FredericSegard/ZedEighty-Project/Part 7 - Keyboard Basic/Part 7 - Keyboard Basic (Rear).jpg

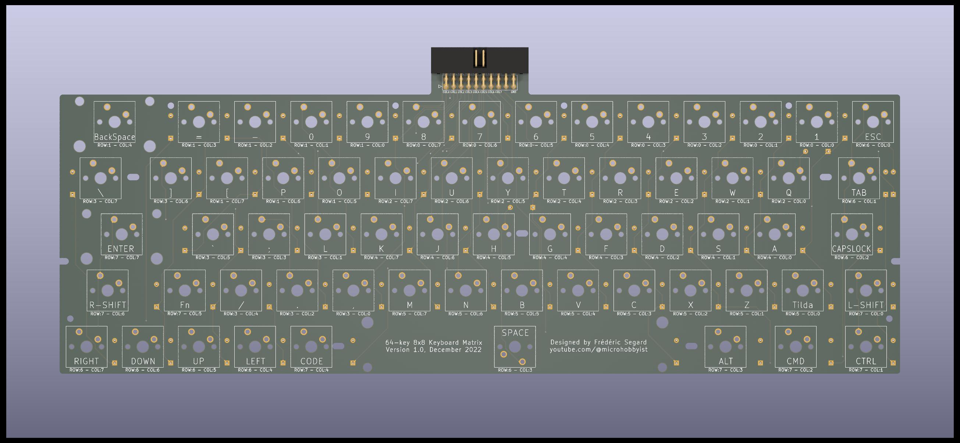
Part 7 - Keyboard Basic/Part 7 - Keyboard Basic (Rear).jpg
