FredericSegard/ZedEighty-Project/Part 7 - Keyboard Basic/Part 7 - Keyboard Basic (Angle).jpg

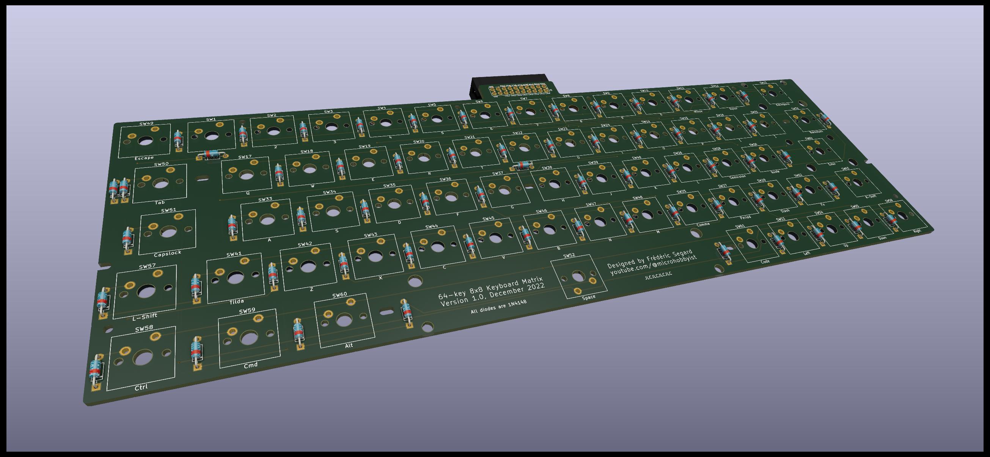
Part 7 - Keyboard Basic/Part 7 - Keyboard Basic (Angle).jpg
