FredericSegard/ZedEighty-Project/Part 3 - Mapping things out/ResetClockCardBack.jpg

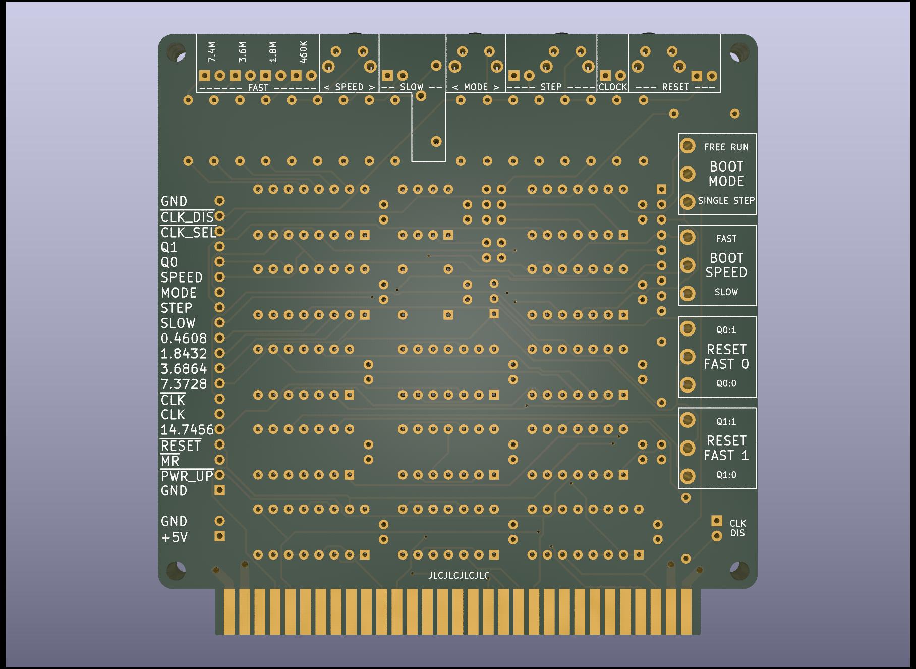
Part 3 - Mapping things out/ResetClockCardBack.jpg
