FredericSegard/ZedEighty-Project/Part 3 - Mapping things out/ResetClockCardFront.jpg

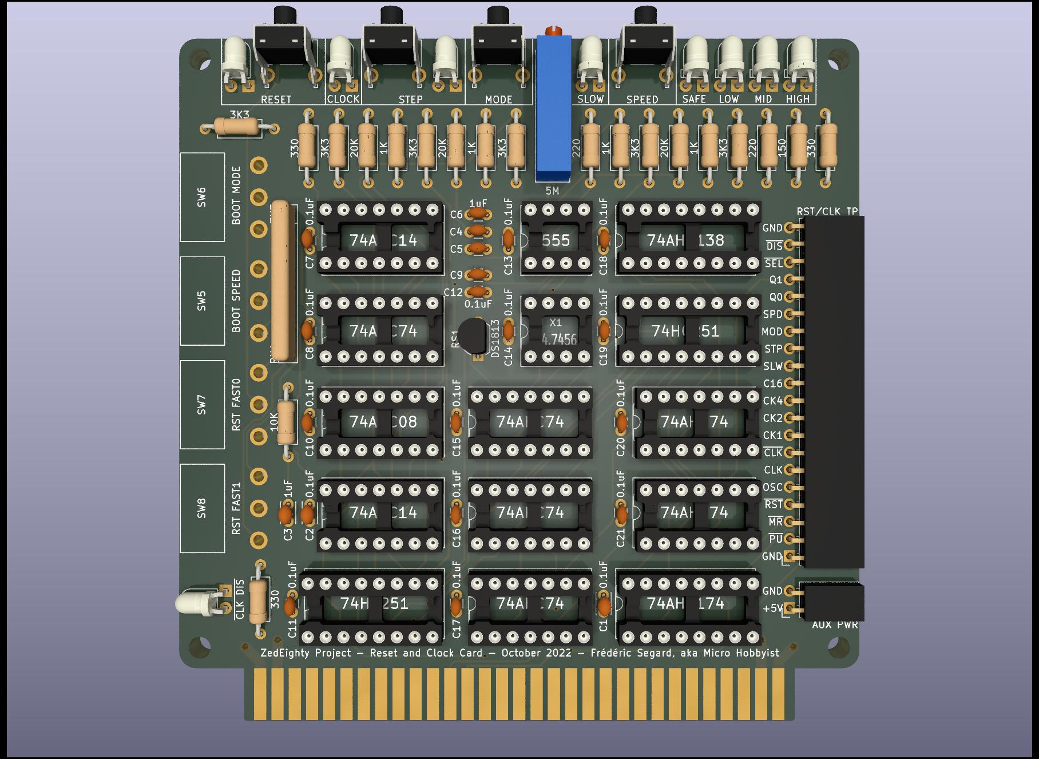
Part 3 - Mapping things out/ResetClockCardFront.jpg
