FredericSegard/ZedEighty-Project/Part 7 - Keyboard Basic/Part 7 - Keyboard Basic (Schematic).jpg

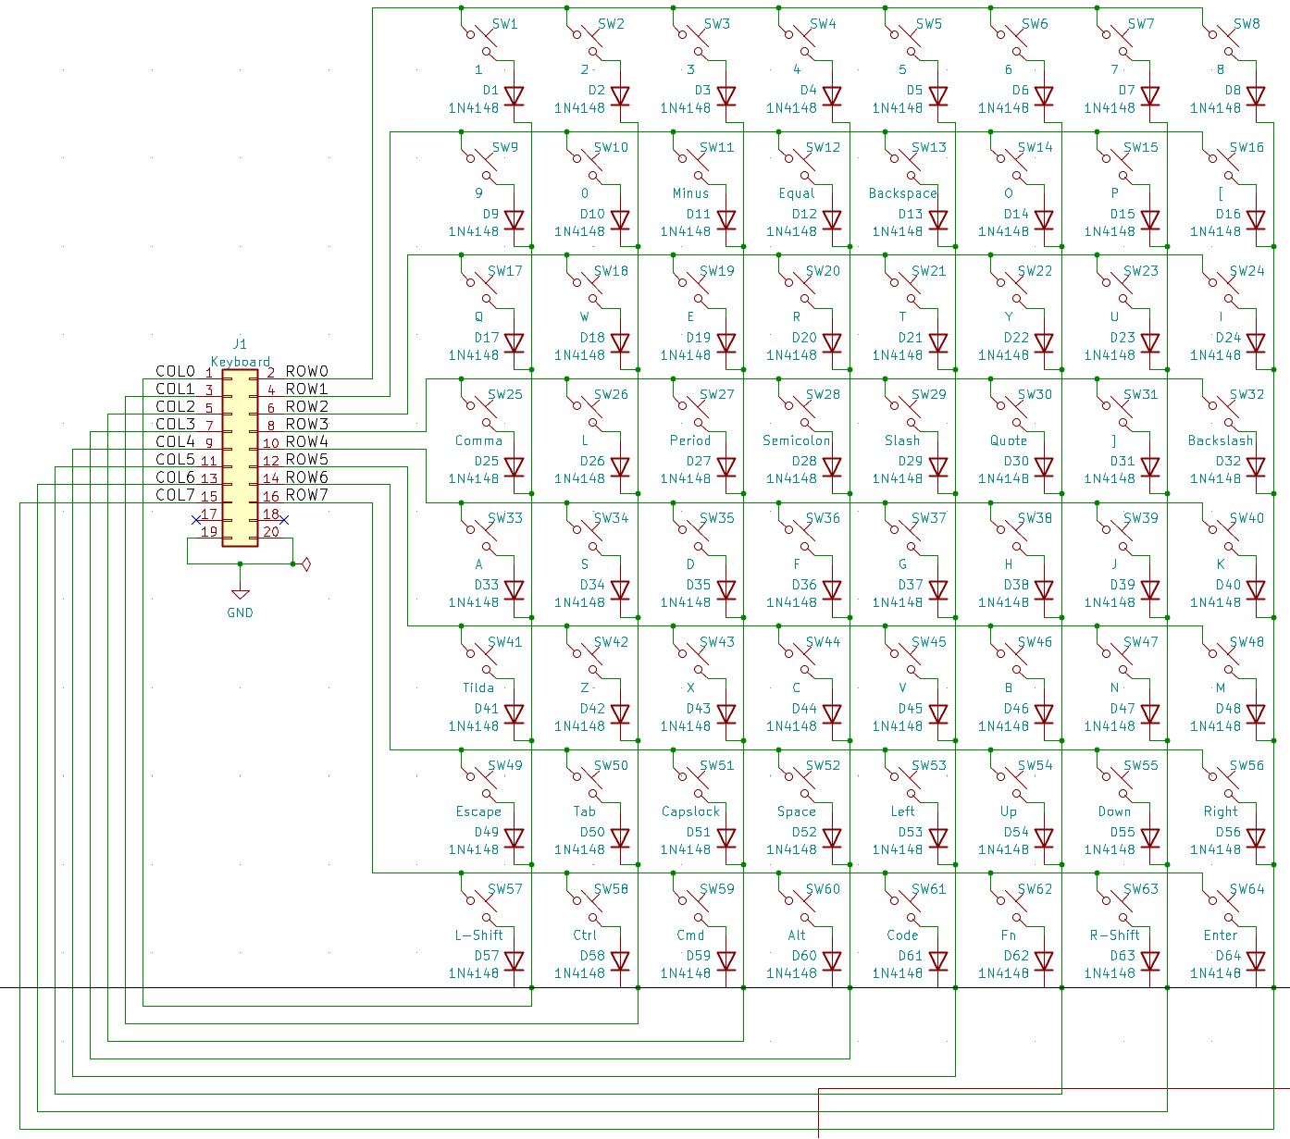
Part 7 - Keyboard Basic/Part 7 - Keyboard Basic (Schematic).jpg
