FredericSegard/ZedEighty-Project/0_Z80_Library/SW_Cherry_MX_PCB.step

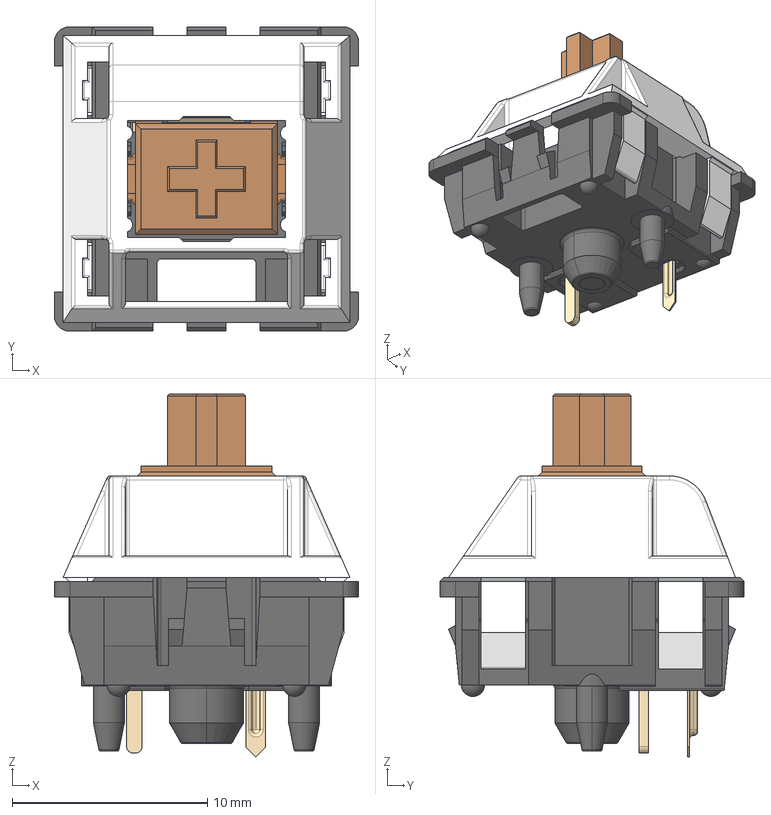
[picture p6: CAD file, 2022-11-07]
0_Z80_Library/SW_Cherry_MX_PCB.step
15.6 x 15.6 x 18.6 mm
