FredericSegard/ZedEighty-Project/0_Z80_Library/Stabilizer_Cherry_MX_6_25u.step

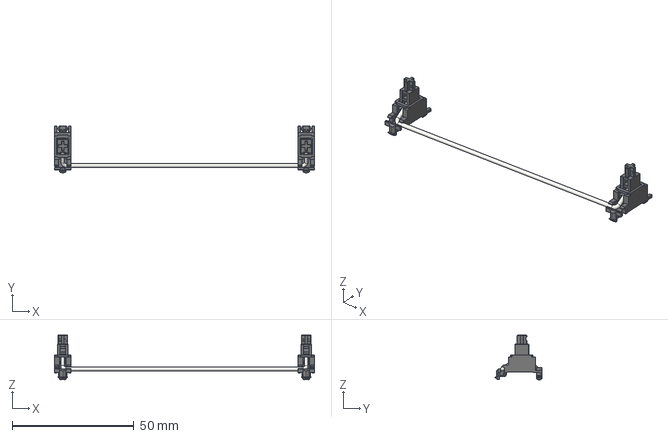
[picture p7: CAD file, 2022-11-07]
0_Z80_Library/Stabilizer_Cherry_MX_6_25u.step
106.8 x 19.2 x 18.3 mm
