FredericSegard/ZedEighty-Project/0_Z80_Library/Stabilizer_Cherry_MX_2u.step

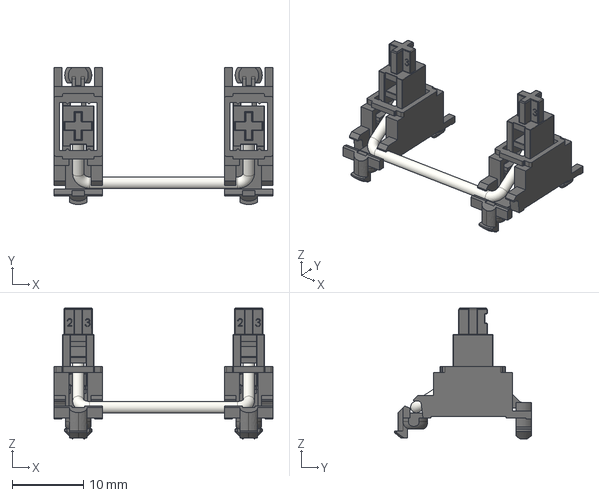
[picture p8: CAD file, 2022-11-07]
0_Z80_Library/Stabilizer_Cherry_MX_2u.step
30.7 x 19.2 x 18.3 mm
