FredericSegard/ZedEighty-Project/0_Z80_Library/M2012S2A2W30.step

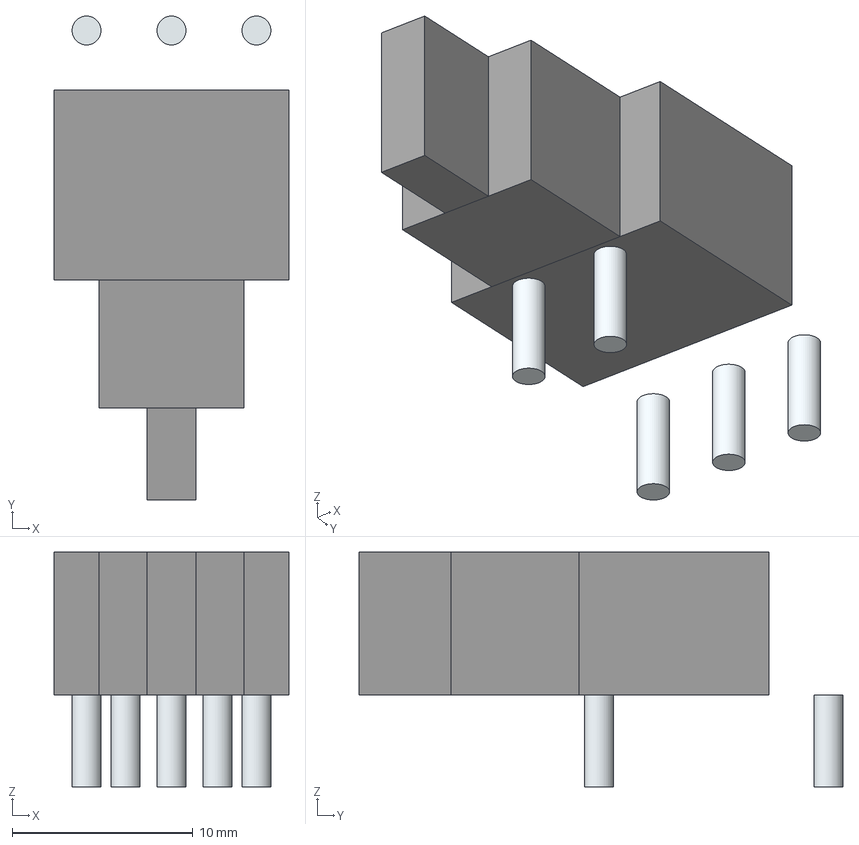
[picture p9: CAD file, 2022-10-14]
0_Z80_Library/M2012S2A2W30.step
13.0 x 26.8 x 13.0 mm
Leads x 5
