FredericSegard/ZedEighty-Project/Part 1 - Testing the Z80/Part 1 - Testing the Z80.pdf

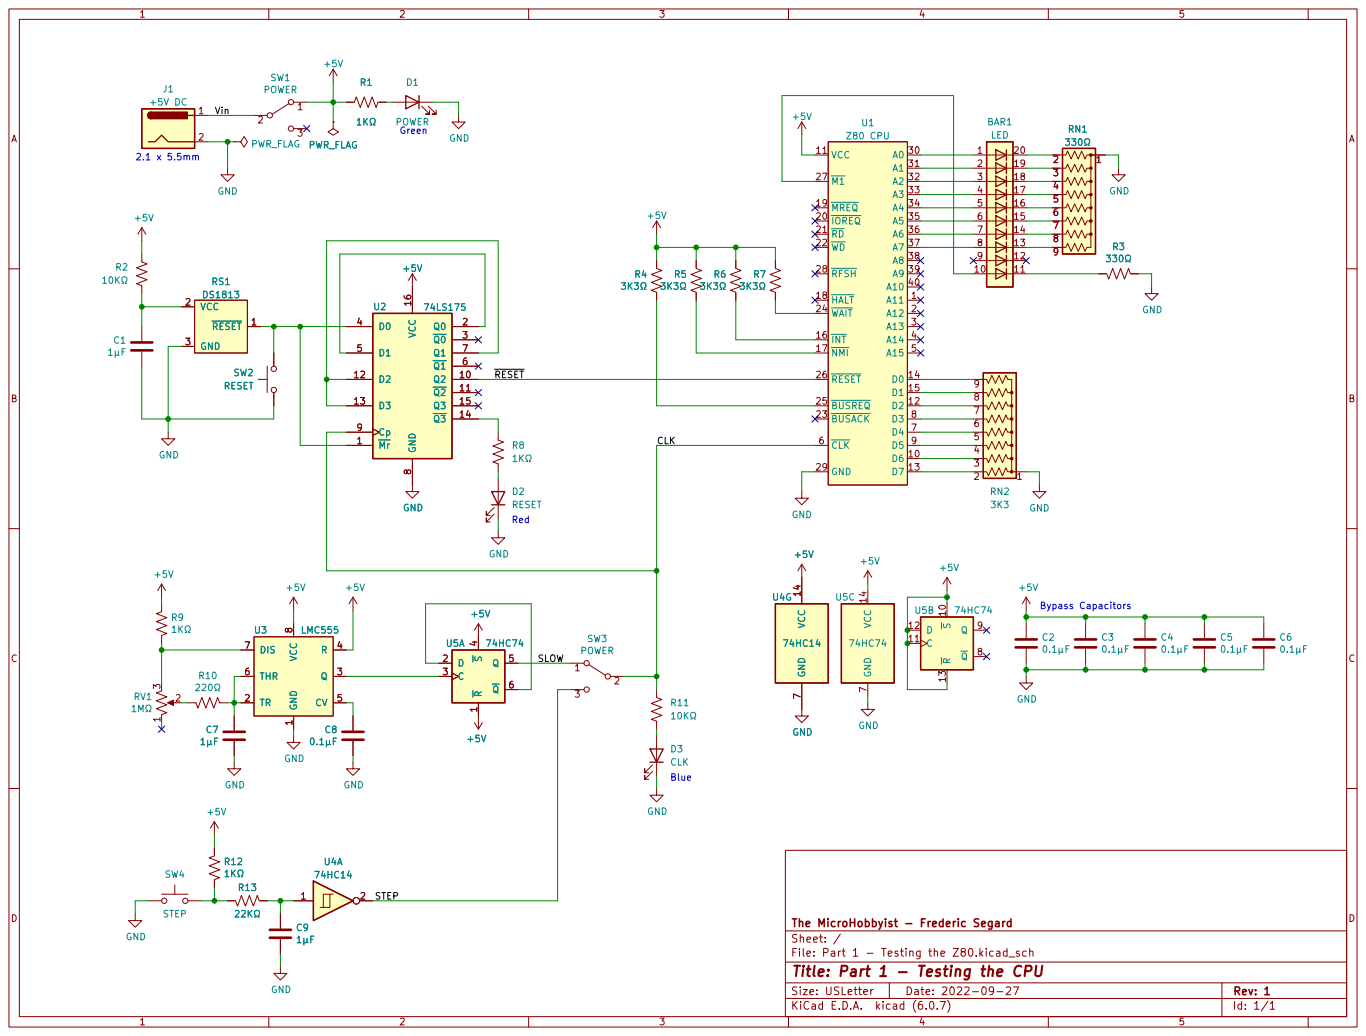
[picture p10: page 1]

9 BAR1 2 | 19

3 | 18
4 | 17
5 | 16
6 | 15
7 | 14
8 | 13

File: Part 1 - Testing the Z80.kicad_sch Sheet: / The MicroHobbyist - Frederic Segard

Id: 1/1 Title: Part 1 - Testing the CPU
