FredericSegard/ZedEighty-Project/Part 3 - Mapping things out/Part 3 - Jellybean logic instead of PLD.pdf

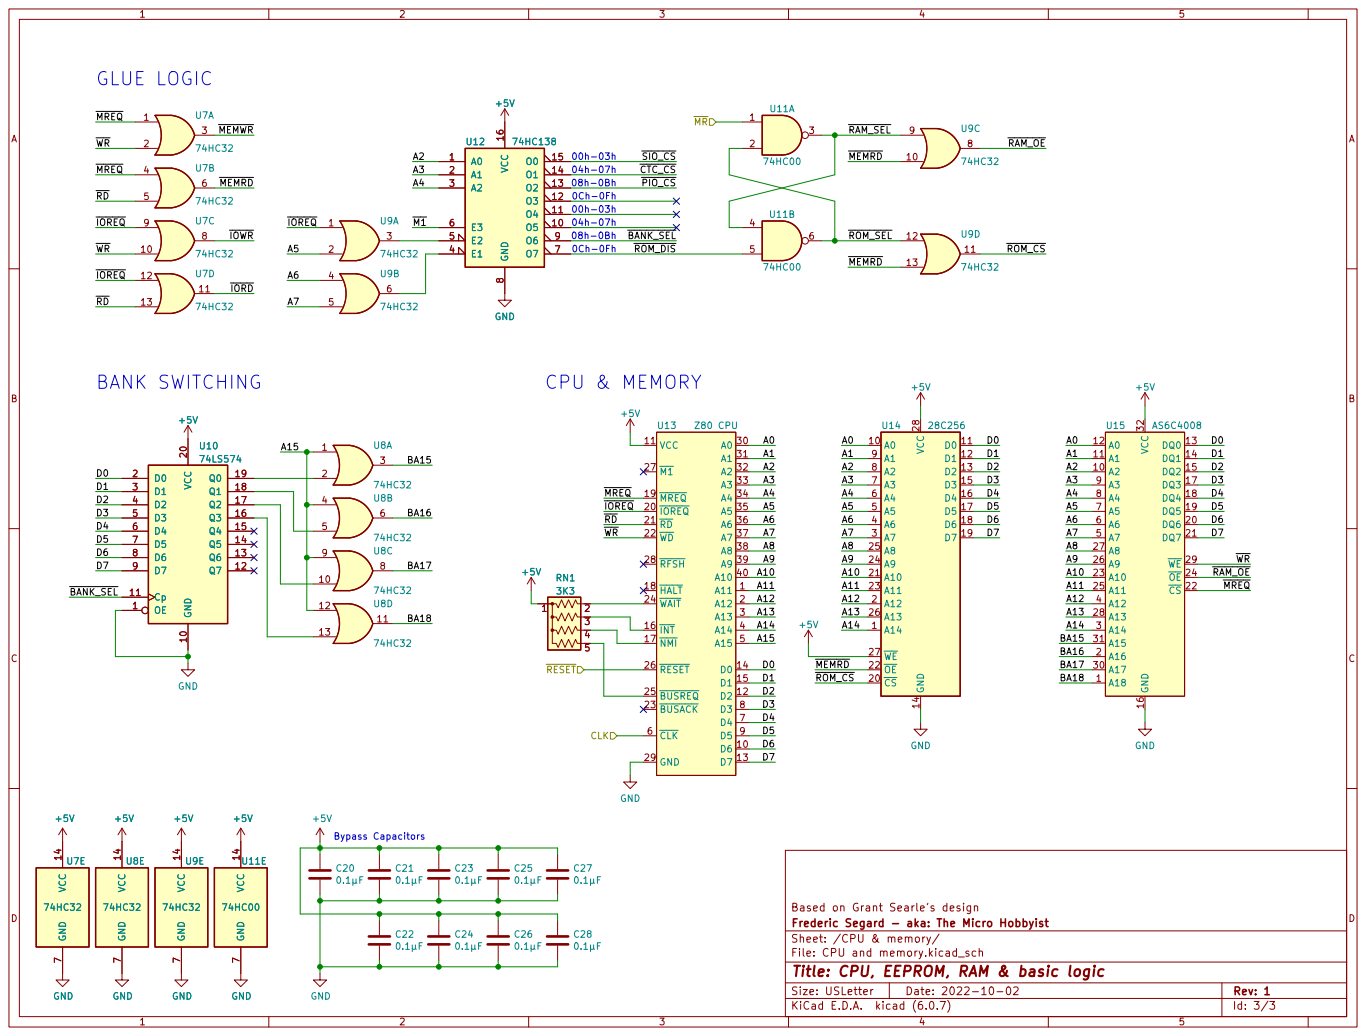
[picture p11: page 1]

Frederic Segard - aka: The Micro Hobbyist
Sheet: /CPU & memory/
File: CPU and memory.kicad_sch
Id: 3/3 Title: CPU, EEPROM, RAM & basic logic
