FredericSegard/ZedEighty-Project/(list of files, drawings)

Other design files:
Part 3 - Clock v3/FastClockSwitching.circ
Part 3 - Clock v3/Part 3 - Clock v3.dsn
Part 3 - Mapping things out/Part 3 - Mapping things out.dsn
Part 3 - Mapping things out/SimulateGlueLogic.circ
Part 3 - Mapping things out/Speed_RGB_LED.circ
Part 4 - CPU and memory v2/Part 4 - CPU and memory v2.dsn
Part 6 - SIO CTC/Part 6 - SIO CTC.dsn
Part 7 - Keyboard Basic/Part 7 - Keyboard Basic.dsn
Part 7 - Keyboard/Part 7 - Keyboard.dsn
