FredericSegard/ZedEighty-Project/Part 4 - CPU and memory v2/Part 4 - CPU and memory v2.kicad_pcb

## KiCad design Part 4 - CPU and memory v2/Part 4 - CPU and memory v2.kicad_pcb (2023-01-05)

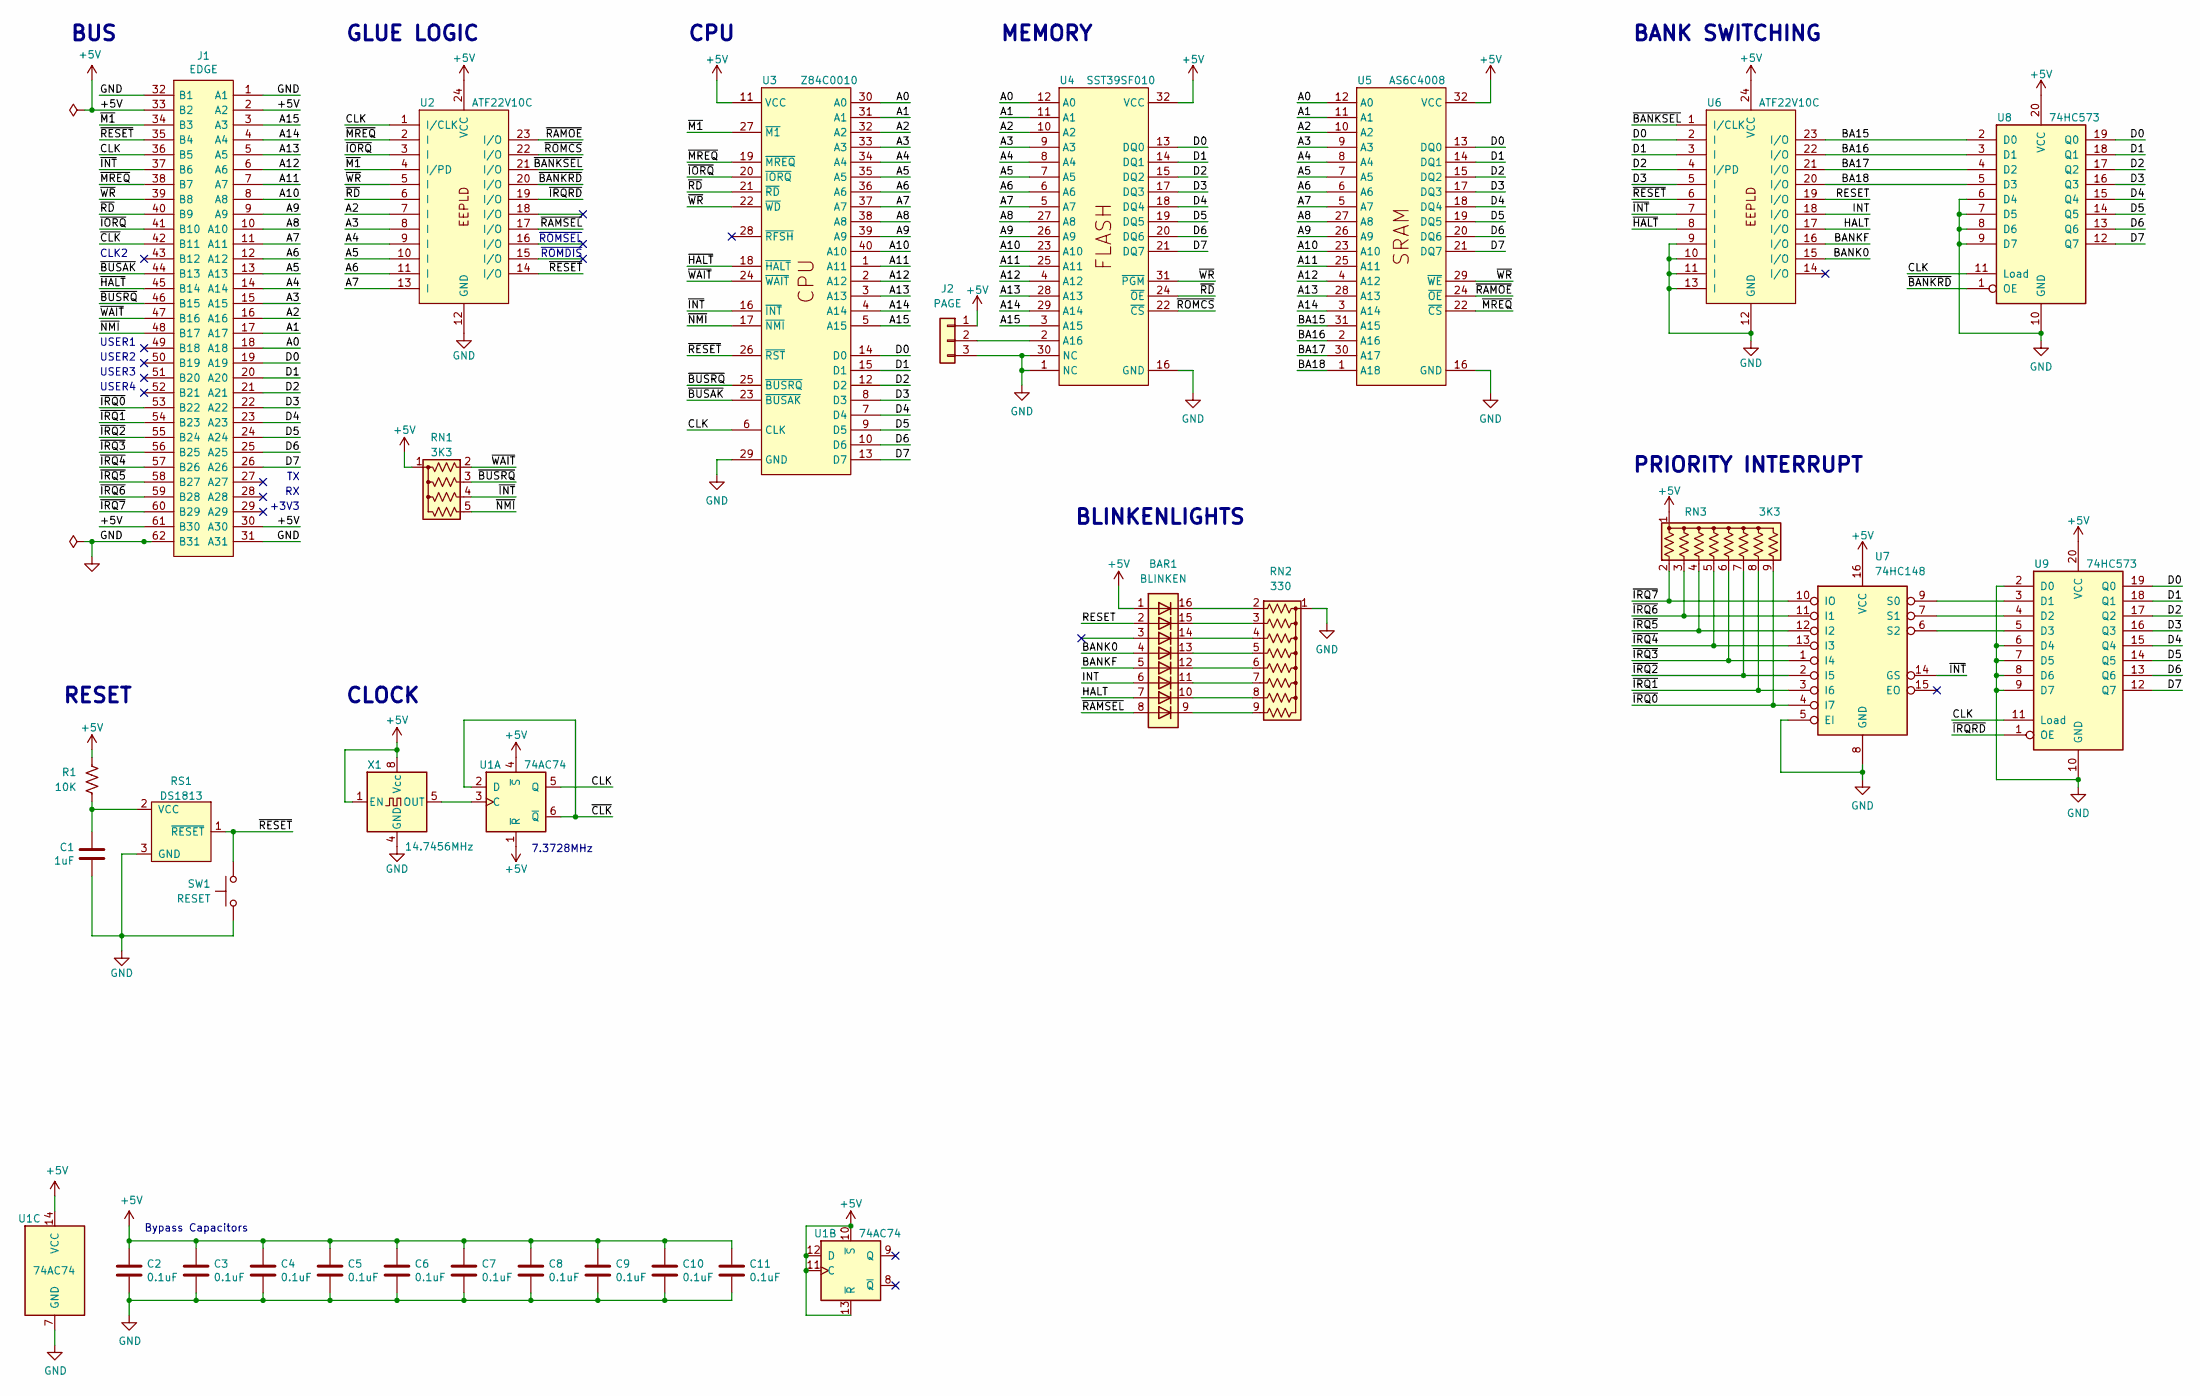
[picture p12: schematic Part 4 - CPU and memory v2.kicad_sch, CPU, 64K FLASH, 512K RAM, with blinkenlights]

Parts:
BAR1: BLINKEN; 8_Segment_Bar_graph
C1: 1uF; C_Disc_D3.0mm_W2.0mm_P2.50mm
C2, C3, C4, C5, C6, C7, C8, C9, C10, C11: 0.1uF; C_Disc_D3.0mm_W1.6mm_P2.50mm
J1: EDGE; BUS_XT; Mouser Part Number 571-6-5530843-5
J2: PAGE; PinHeader_1x03_P2.54mm_Vertical
R1: 10K; R_Axial_DIN0207_L6.3mm_D2.5mm_P10.16mm_Horizontal
RN1: 3K3; R_Array_SIP5
RN2: 330; R_Array_SIP9
RN3: 3K3; R_Array_SIP9
RS1: DS1813; TO-92L_Inline_Wide
SW1: RESET; SW_Tactile_SPST_Angled_PTS645Vx58-2LFS
U1: 74AC74; DIP-14_W7.62mm_Socket
U2, U6: ATF22V10C; DIP-24_W7.62mm_Socket
U3: Z84C0010; DIP-40_W15.24mm_Socket
U4: SST39SF010; DIP_Socket-32_W11.9_W12.7_W15.24_W17.78_W18.5_3M_232-1285-0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
U5: AS6C4008; DIP-32_W15.24mm_Socket
U7: 74HC148; DIP-16_W7.62mm_Socket
U8, U9: 74HC573; DIP-20_W7.62mm_Socket
X1: 14.7456MHz; DIP-8-4_W7.62mm_Oscillator_Socket

Connections:
+5V: BAR1.1 (A), C2.1, C3.1, C4.1, C5.1, C6.1, C7.1, C8.1, C9.1, C10.1, C11.1, J1.2 (A2), J1.30 (A30), J1.33 (B2), J1.61 (B30), J2.1, R1.2, RN1.1 (common), RN3.1 (common), U1.1 (~R), U1.4 (~S), U1.10 (~S), U1.11 (C), U1.12 (D), U1.13 (~R), U1.14 (VCC), U2.24 (VCC), U3.11 (VCC), U4.32 (VCC), U5.32 (VCC), U6.24 (VCC), U7.16 (VCC), U8.20 (VCC), U9.20 (VCC), X1.1 (EN), X1.8 (Vcc)
/A0: J1.18 (A18), U3.30 (A0), U4.12 (A0), U5.12 (A0)
/A1: J1.17 (A17), U3.31 (A1), U4.11 (A1), U5.11 (A1)
/A2: J1.16 (A16), U2.7 (I), U3.32 (A2), U4.10 (A2), U5.10 (A2)
/A3: J1.15 (A15), U2.8 (I), U3.33 (A3), U4.9 (A3), U5.9 (A3)
/A4: J1.14 (A14), U2.9 (I), U3.34 (A4), U4.8 (A4), U5.8 (A4)
/A5: J1.13 (A13), U2.10 (I), U3.35 (A5), U4.7 (A5), U5.7 (A5)
/A6: J1.12 (A12), U2.11 (I), U3.36 (A6), U4.6 (A6), U5.6 (A6)
/A7: J1.11 (A11), U2.13 (I), U3.37 (A7), U4.5 (A7), U5.5 (A7)
/A8: J1.10 (A10), U3.38 (A8), U4.27 (A8), U5.27 (A8)
/A9: J1.9 (A9), U3.39 (A9), U4.26 (A9), U5.26 (A9)
/A10: J1.8 (A8), U3.40 (A10), U4.23 (A10), U5.23 (A10)
/A11: J1.7 (A7), U3.1 (A11), U4.25 (A11), U5.25 (A11)
/A12: J1.6 (A6), U3.2 (A12), U4.4 (A12), U5.4 (A12)
/A13: J1.5 (A5), U3.3 (A13), U4.28 (A13), U5.28 (A13)
/A14: J1.4 (A4), U3.4 (A14), U4.29 (A14), U5.3 (A14)
/A15: J1.3 (A3), U3.5 (A15), U4.3 (A15)
/BA15: U5.31 (A15), U6.23 (I/O), U8.2 (D0)
/BA16: U5.2 (A16), U6.22 (I/O), U8.3 (D1)
/BA17: U5.30 (A17), U6.21 (I/O), U8.4 (D2)
/BA18: U5.1 (A18), U6.20 (I/O), U8.5 (D3)
/BANK0: BAR1.4 (A), U6.15 (I/O)
/BANKF: BAR1.5 (A), U6.16 (I/O)
/CLK: J1.36 (B5), U1.5 (Q), U2.1 (I/CLK), U3.6 (CLK), U8.11 (Load), U9.11 (Load)
/D0: J1.19 (A19), U3.14 (D0), U4.13 (DQ0), U5.13 (DQ0), U6.2 (I), U8.19 (Q0), U9.19 (Q0)
/D1: J1.20 (A20), U3.15 (D1), U4.14 (DQ1), U5.14 (DQ1), U6.3 (I), U8.18 (Q1), U9.18 (Q1)
/D2: J1.21 (A21), U3.12 (D2), U4.15 (DQ2), U5.15 (DQ2), U6.4 (I/PD), U8.17 (Q2), U9.17 (Q2)
/D3: J1.22 (A22), U3.8 (D3), U4.17 (DQ3), U5.17 (DQ3), U6.5 (I), U8.16 (Q3), U9.16 (Q3)
/D4: J1.23 (A23), U3.7 (D4), U4.18 (DQ4), U5.18 (DQ4), U8.15 (Q4), U9.15 (Q4)
/D5: J1.24 (A24), U3.9 (D5), U4.19 (DQ5), U5.19 (DQ5), U8.14 (Q5), U9.14 (Q5)
/D6: J1.25 (A25), U3.10 (D6), U4.20 (DQ6), U5.20 (DQ6), U8.13 (Q6), U9.13 (Q6)
/D7: J1.26 (A26), U3.13 (D7), U4.21 (DQ7), U5.21 (DQ7), U8.12 (Q7), U9.12 (Q7)
/HALT: BAR1.7 (A), U6.17 (I/O)
/INT: BAR1.6 (A), U6.18 (I/O)
/RESET: BAR1.2 (A), U6.19 (I/O)
/~BANKRD: U2.20 (I/O), U8.1 (OE)
/~BANKSEL: U2.21 (I/O), U6.1 (I/CLK)
/~BUSAK: J1.44 (B13), U3.23 (~BUSAK)
/~BUSRQ: J1.46 (B15), RN1.3 (R2), U3.25 (~BUSRQ)
/~CLK: J1.42 (B11), U1.2 (D), U1.6 (~Q)
/~HALT: J1.45 (B14), U3.18 (~HALT), U6.8 (I)
/~INT: J1.37 (B6), RN1.4 (R3), U3.16 (~INT), U6.7 (I), U7.14 (GS)
/~IORQ: J1.41 (B10), U2.3 (I), U3.20 (~IORQ)
/~IRQ0: J1.53 (B22), RN3.9 (R8), U7.4 (I7)
/~IRQ1: J1.54 (B23), RN3.8 (R7), U7.3 (I6)
/~IRQ2: J1.55 (B24), RN3.7 (R6), U7.2 (I5)
/~IRQ3: J1.56 (B25), RN3.6 (R5), U7.1 (I4)
/~IRQ4: J1.57 (B26), RN3.5 (R4), U7.13 (I3)
/~IRQ5: J1.58 (B27), RN3.4 (R3), U7.12 (I2)
/~IRQ6: J1.59 (B28), RN3.3 (R2), U7.11 (I1)
/~IRQ7: J1.60 (B29), RN3.2 (R1), U7.10 (IO)
/~IRQRD: U2.19 (I/O), U9.1 (OE)
/~M1: J1.34 (B3), U2.4 (I/PD), U3.27 (~M1)
/~MREQ: J1.38 (B7), U2.2 (I), U3.19 (~MREQ), U5.22 (~CS)
/~NMI: J1.48 (B17), RN1.5 (R4), U3.17 (~NMI)
/~RAMOE: U2.23 (I/O), U5.24 (~OE)
/~RAMSEL: BAR1.8 (A), U2.17 (I/O)
/~RD: J1.40 (B9), U2.6 (I), U3.21 (~RD), U4.24 (~OE)
/~RESET: J1.35 (B4), RS1.1 (~RESET), SW1.1, U2.14 (I/O), U3.26 (~RST), U6.6 (I)
/~ROMCS: U2.22 (I/O), U4.22 (~CS)
/~WAIT: J1.47 (B16), RN1.2 (R1), U3.24 (~WAIT)
/~WR: J1.39 (B8), U2.5 (I), U3.22 (~WD), U4.31 (~PGM), U5.29 (~WE)
GND: C1.2, C2.2, C3.2, C4.2, C5.2, C6.2, C7.2, C8.2, C9.2, C10.2, C11.2, J1.1 (A1), J1.31 (A31), J1.32 (B1), J1.62 (B31), J2.3, RN2.1 (common), RS1.3 (GND), SW1.2, U1.7 (GND), U2.12 (GND), U3.29 (GND), U4.1 (NC), U4.16 (GND), U4.30 (NC), U5.16 (GND), U6.9 (I), U6.10 (I), U6.11 (I), U6.12 (GND), U6.13 (I), U7.5 (EI), U7.8 (GND), U8.6 (D4), U8.7 (D5), U8.8 (D6), U8.9 (D7), U8.10 (GND), U9.2 (D0), U9.6 (D4), U9.7 (D5), U9.8 (D6), U9.9 (D7), U9.10 (GND), X1.4 (GND)
unnamed: BAR1.9 (A), RN2.9 (R8)
unnamed: BAR1.10 (A), RN2.8 (R7)
unnamed: BAR1.11 (K), RN2.7 (R6)
unnamed: BAR1.12 (K), RN2.6 (R5)
unnamed: BAR1.13 (K), RN2.5 (R4)
unnamed: BAR1.14 (K), RN2.4 (R3)
unnamed: BAR1.15 (K), RN2.3 (R2)
unnamed: BAR1.16 (K), RN2.2 (R1)
unnamed: C1.1, R1.1, RS1.2 (VCC)
unnamed: J2.2, U4.2 (A16)
unnamed: U1.3 (C), X1.5 (OUT)
unnamed: U7.6 (S2), U9.5 (D3)
unnamed: U7.7 (S1), U9.4 (D2)
unnamed: U7.9 (S0), U9.3 (D1)

Notes on the sheet:
MEMORY
BUS
BLINKENLIGHTS
CLK2
CPU
PRIORITY INTERRUPT
USER2
RESET
USER4
7.3728MHz
BANK SWITCHING
USER3
USER1
~{ROMDIS}
Bypass Capacitors
CLOCK
GLUE LOGIC
+3V3
~{ROMSEL}

Board: 2 copper layers, 30 parts (0 on the bottom side), 77 nets, no tracks yet.
