FredericSegard/ZedEighty-Project/Part 6 - SIO CTC/Part 6 - SIO CTC.kicad_pcb

## KiCad design Part 6 - SIO CTC/Part 6 - SIO CTC.kicad_pcb (2023-01-05)

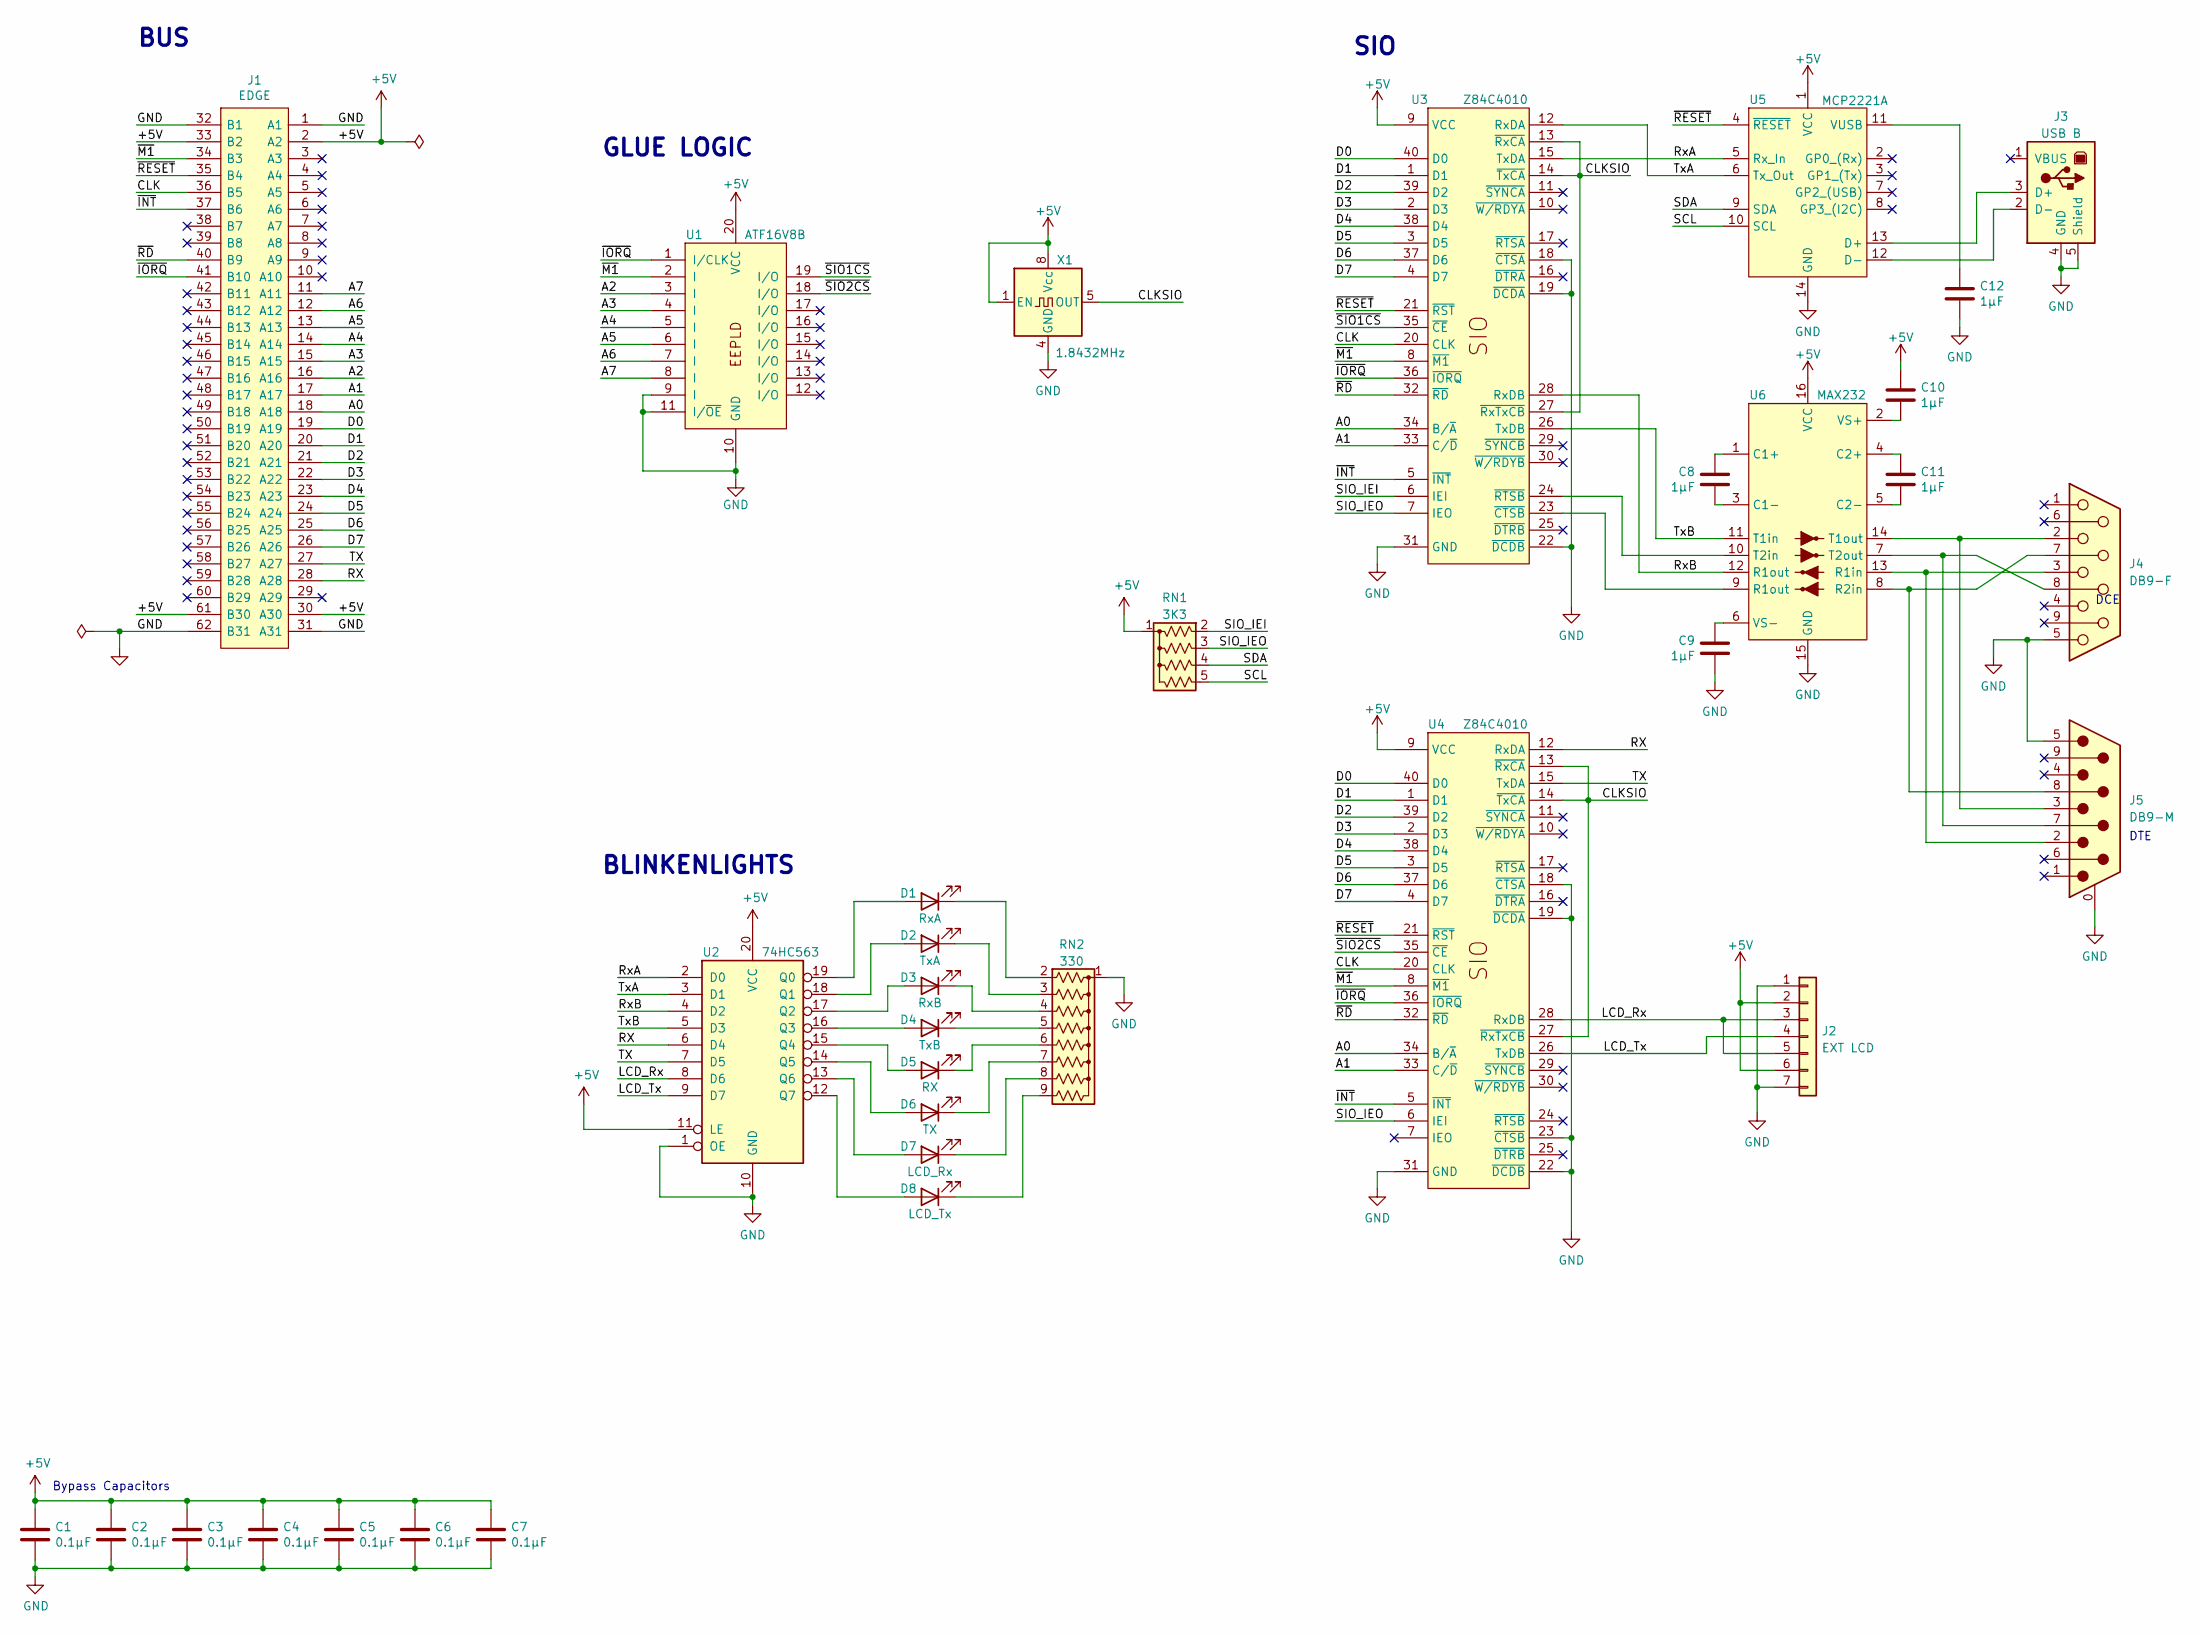
[picture p13: schematic Part 6 - SIO CTC.kicad_sch, SIO and CTC]

Parts:
C1, C2, C3, C4, C5, C6, C7: 0.1µF; C_Disc_D3.0mm_W1.6mm_P2.50mm
C8, C9, C10, C11, C12: 1µF; C_Disc_D3.0mm_W1.6mm_P2.50mm
D1: RxA; LED_D3.0mm_Horizontal_O1.27mm_Z2.0mm_Clear
D2: TxA; LED_D3.0mm_Horizontal_O1.27mm_Z2.0mm_Clear
D3: RxB; LED_D3.0mm_Horizontal_O1.27mm_Z2.0mm_Clear
D4: TxB; LED_D3.0mm_Horizontal_O1.27mm_Z2.0mm_Clear
D5: RX; LED_D3.0mm_Horizontal_O1.27mm_Z2.0mm_Clear
D6: TX; LED_D3.0mm_Horizontal_O1.27mm_Z2.0mm_Clear
D7: LCD_Rx; LED_D3.0mm_Horizontal_O1.27mm_Z2.0mm_Clear
D8: LCD_Tx; LED_D3.0mm_Horizontal_O1.27mm_Z2.0mm_Clear
J1: EDGE; BUS_XT; Mouser Part Number 571-6-5530843-5
J2: EXT LCD; PinHeader_1x07_P2.54mm_Horizontal
J3: USB B; USB_B_Lumberg_2411_02_Horizontal
J4: DB9-F; DSUB-9_Female_Horizontal_P2.77x2.84mm_EdgePinOffset7.70mm_H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
J5: DB9-M; DSUB-9_Male_Horizontal_P2.77x2.84mm_EdgePinOffset7.70mm_Hou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
RN1: 3K3; R_Array_SIP5
RN2: 330; R_Array_SIP9
U1: ATF16V8B; DIP-20_W7.62mm_Socket
U2: 74HC563; DIP-20_W7.62mm_Socket
U3, U4: Z84C4010; DIP-40_W15.24mm_Socket
U5: MCP2221A; DIP-14_W7.62mm_Socket
U6: MAX232; DIP-16_W7.62mm_Socket
X1: 1.8432MHz; DIP-8-4_W7.62mm_Oscillator_Socket

Connections:
+5V: C1.1, C2.1, C3.1, C4.1, C5.1, C6.1, C7.1, C10.1, J1.2 (A2), J1.30 (A30), J1.33 (B2), J1.61 (B30), J2.2, J2.6, RN1.1 (common), U1.20 (VCC), U2.11 (LE), U2.20 (VCC), U3.9 (VCC), U4.9 (VCC), U5.1 (VCC), U6.16 (VCC), X1.1 (EN), X1.8 (Vcc)
/A0: J1.18 (A18), U3.34 (B/~A), U4.34 (B/~A)
/A1: J1.17 (A17), U3.33 (C/~D), U4.33 (C/~D)
/A2: J1.16 (A16), U1.3 (I)
/A3: J1.15 (A15), U1.4 (I)
/A4: J1.14 (A14), U1.5 (I)
/A5: J1.13 (A13), U1.6 (I)
/A6: J1.12 (A12), U1.7 (I)
/A7: J1.11 (A11), U1.8 (I)
/CLK: J1.36 (B5), U3.20 (CLK), U4.20 (CLK)
/CLKSIO: U3.13 (~RxCA), U3.14 (~TxCA), U3.27 (~RxTxCB), U4.13 (~RxCA), U4.14 (~TxCA), U4.27 (~RxTxCB), X1.5 (OUT)
/D0: J1.19 (A19), U3.40 (D0), U4.40 (D0)
/D1: J1.20 (A20), U3.1 (D1), U4.1 (D1)
/D2: J1.21 (A21), U3.39 (D2), U4.39 (D2)
/D3: J1.22 (A22), U3.2 (D3), U4.2 (D3)
/D4: J1.23 (A23), U3.38 (D4), U4.38 (D4)
/D5: J1.24 (A24), U3.3 (D5), U4.3 (D5)
/D6: J1.25 (A25), U3.37 (D6), U4.37 (D6)
/D7: J1.26 (A26), U3.4 (D7), U4.4 (D7)
/LCD_Rx: J2.3, J2.5, U2.8 (D6), U4.28 (RxDB)
/LCD_Tx: J2.4, U2.9 (D7), U4.26 (TxDB)
/RX: J1.28 (A28), U2.6 (D4), U4.12 (RxDA)
/RxA: U2.2 (D0), U3.15 (TxDA), U5.5 (Rx_In)
/RxB: U2.4 (D2), U3.28 (RxDB), U6.12 (R1out)
/SCL: RN1.5 (R4), U5.10 (SCL)
/SDA: RN1.4 (R3), U5.9 (SDA)
/SIO_IEI: RN1.2 (R1), U3.6 (IEI)
/SIO_IEO: RN1.3 (R2), U3.7 (IEO), U4.6 (IEI)
/TX: J1.27 (A27), U2.7 (D5), U4.15 (TxDA)
/TxA: U2.3 (D1), U3.12 (RxDA), U5.6 (Tx_Out)
/TxB: U2.5 (D3), U3.26 (TxDB), U6.11 (T1in)
/~INT: J1.37 (B6), U3.5 (~INT), U4.5 (~INT)
/~IORQ: J1.41 (B10), U1.1 (I/CLK), U3.36 (~IORQ), U4.36 (~IORQ)
/~M1: J1.34 (B3), U1.2 (I), U3.8 (~M1), U4.8 (~M1)
/~RD: J1.40 (B9), U3.32 (~RD), U4.32 (~RD)
/~RESET: J1.35 (B4), U3.21 (~RST), U4.21 (~RST), U5.4 (~RESET)
/~SIO1CS: U1.19 (I/O), U3.35 (~CE)
/~SIO2CS: U1.18 (I/O), U4.35 (~CE)
GND: C1.2, C2.2, C3.2, C4.2, C5.2, C6.2, C7.2, C9.2, C12.2, J1.1 (A1), J1.31 (A31), J1.32 (B1), J1.62 (B31), J2.1, J2.7, J3.4 (GND), J3.5 (Shield), J4.5, J5.0 (PAD), J5.5, RN2.1 (common), U1.9 (I), U1.10 (GND), U1.11 (I/~OE), U2.1 (OE), U2.10 (GND), U3.18 (~CTSA), U3.19 (~DCDA), U3.22 (~DCDB), U3.31 (GND), U4.18 (~CTSA), U4.19 (~DCDA), U4.22 (~DCDB), U4.23 (~CTSB), U4.31 (GND), U5.14 (GND), U6.15 (GND), X1.4 (GND)
unnamed: C8.1, U6.1 (C1+)
unnamed: C8.2, U6.3 (C1-)
unnamed: C9.1, U6.6 (VS-)
unnamed: C10.2, U6.2 (VS+)
unnamed: C11.1, U6.4 (C2+)
unnamed: C11.2, U6.5 (C2-)
unnamed: C12.1, U5.11 (VUSB)
unnamed: D1.1 (K), RN2.2 (R1)
unnamed: D1.2 (A), U2.19 (Q0)
unnamed: D2.1 (K), RN2.3 (R2)
unnamed: D2.2 (A), U2.18 (Q1)
unnamed: D3.1 (K), RN2.4 (R3)
unnamed: D3.2 (A), U2.17 (Q2)
unnamed: D4.1 (K), RN2.5 (R4)
unnamed: D4.2 (A), U2.16 (Q3)
unnamed: D5.1 (K), RN2.6 (R5)
unnamed: D5.2 (A), U2.15 (Q4)
unnamed: D6.1 (K), RN2.7 (R6)
unnamed: D6.2 (A), U2.14 (Q5)
unnamed: D7.1 (K), RN2.8 (R7)
unnamed: D7.2 (A), U2.13 (Q6)
unnamed: D8.1 (K), RN2.9 (R8)
unnamed: D8.2 (A), U2.12 (Q7)
unnamed: J3.2 (D-), U5.12 (D-)
unnamed: J3.3 (D+), U5.13 (D+)
unnamed: J4.2, J5.3, U6.14 (T1out)
unnamed: J4.3, J5.2, U6.13 (R1in)
unnamed: J4.7, J5.8, U6.8 (R2in)
unnamed: J4.8, J5.7, U6.7 (T2out)
unnamed: U3.23 (~CTSB), U6.9 (R1out)
unnamed: U3.24 (~RTSB), U6.10 (T2in)

Notes on the sheet:
DTE
BLINKENLIGHTS
BUS
SIO
Bypass Capacitors
GLUE LOGIC
DCE

Board: 2 copper layers, 34 parts (0 on the bottom side), 70 nets, no tracks yet.
