FredericSegard/ZedEighty-Project/Part 3 - Clock v3/Part 3 - Clock v3.kicad_pcb

## KiCad design Part 3 - Clock v3/Part 3 - Clock v3.kicad_pcb (2022-12-04)

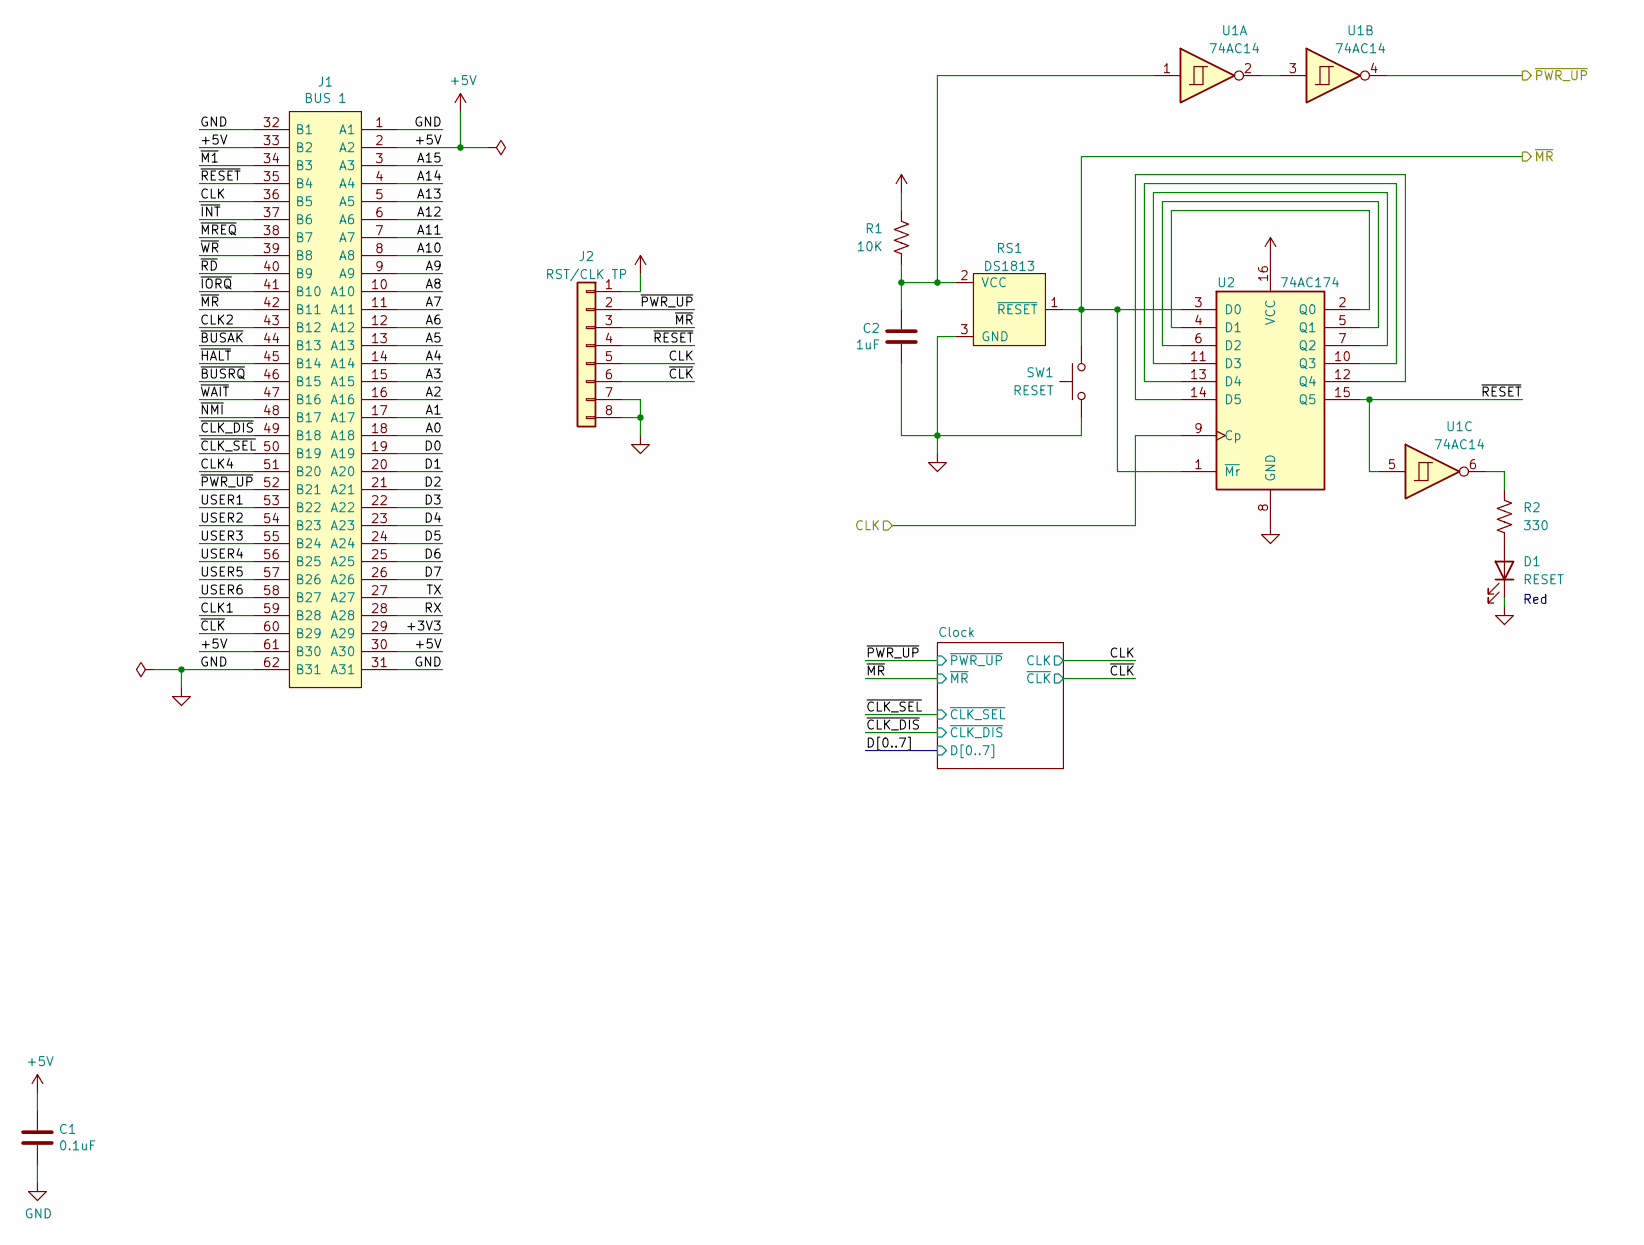
[picture p16: schematic Part 3 - Clock v3.kicad_sch, Micro Hobbyist's ZedEighty Project]

Parts:
C1: 0.1uF; C_Disc_D3.0mm_W2.0mm_P2.50mm
C2: 1uF; C_Disc_D3.0mm_W2.0mm_P2.50mm
D1: RESET; LED_D3.0mm_Horizontal_O1.27mm_Z2.0mm_Clear
J1: BUS 1; BUS_XT; Mouser Part Number 571-6-5530843-5
J2: RST/CLK TP; PinHeader_1x08_P2.54mm_Horizontal
R1: 10K; R_Axial_DIN0207_L6.3mm_D2.5mm_P10.16mm_Horizontal
R2: 330; R_Axial_DIN0207_L6.3mm_D2.5mm_P10.16mm_Horizontal
RS1: DS1813; TO-92L_Inline_Wide
SW1: RESET; SW_Tactile_SPST_Angled_PTS645Vx58-2LFS
U1: 74AC14; DIP-14_W7.62mm_Socket
U2: 74AC174; DIP-16_W7.62mm_Socket

Connections:
/+3V3: J1.29 (A29)
/A0: J1.18 (A18)
/A1: J1.17 (A17)
/A2: J1.16 (A16)
/A3: J1.15 (A15)
/A4: J1.14 (A14)
/A5: J1.13 (A13)
/A6: J1.12 (A12)
/A7: J1.11 (A11)
/A8: J1.10 (A10)
/A9: J1.9 (A9)
/A10: J1.8 (A8)
/A11: J1.7 (A7)
/A12: J1.6 (A6)
/A13: J1.5 (A5)
/A14: J1.4 (A4)
/A15: J1.3 (A3)
/CLK: J1.36 (B5), J2.5, U2.9 (Cp); also elsewhere on the board
/CLK1: J1.59 (B28)
/CLK2: J1.43 (B12)
/CLK4: J1.51 (B20)
/D0: J1.19 (A19); also elsewhere on the board
/D1: J1.20 (A20); also elsewhere on the board
/D2: J1.21 (A21)
/D3: J1.22 (A22)
/D4: J1.23 (A23)
/D5: J1.24 (A24)
/D6: J1.25 (A25)
/D7: J1.26 (A26)
/RX: J1.28 (A28)
/TX: J1.27 (A27)
/USER1: J1.53 (B22)
/USER2: J1.54 (B23)
/USER3: J1.55 (B24)
/USER4: J1.56 (B25)
/USER5: J1.57 (B26)
/USER6: J1.58 (B27)
/~BUSAK: J1.44 (B13)
/~BUSRQ: J1.46 (B15)
/~CLK_DIS: J1.49 (B18); also elsewhere on the board
/~CLK_SEL: J1.50 (B19); also elsewhere on the board
/~CLK: J1.60 (B29), J2.6; also elsewhere on the board
/~HALT: J1.45 (B14)
/~INT: J1.37 (B6)
/~IORQ: J1.41 (B10)
/~M1: J1.34 (B3)
/~MREQ: J1.38 (B7)
/~MR: J1.42 (B11), J2.3, RS1.1 (~RESET), SW1.1, U2.1 (~Mr), U2.3 (D0); also elsewhere on the board
/~NMI: J1.48 (B17)
/~PWR_UP: J1.52 (B21), J2.2, U1.4; also elsewhere on the board
/~RD: J1.40 (B9)
/~RESET: J1.35 (B4), J2.4, U1.5, U2.15 (Q5)
/~WAIT: J1.47 (B16)
/~WR: J1.39 (B8)
unnamed: C2.1, R1.1, RS1.2 (VCC), U1.1
unnamed: D1.2 (A), R2.2
unnamed: R2.1, U1.6
unnamed: U1.2, U1.3
unnamed: U2.2 (Q0), U2.4 (D1)
unnamed: U2.5 (Q1), U2.6 (D2)
unnamed: U2.10 (Q3), U2.13 (D4)
unnamed: U2.7 (Q2), U2.11 (D3)
unnamed: U2.12 (Q4), U2.14 (D5)

Notes on the sheet:
Red

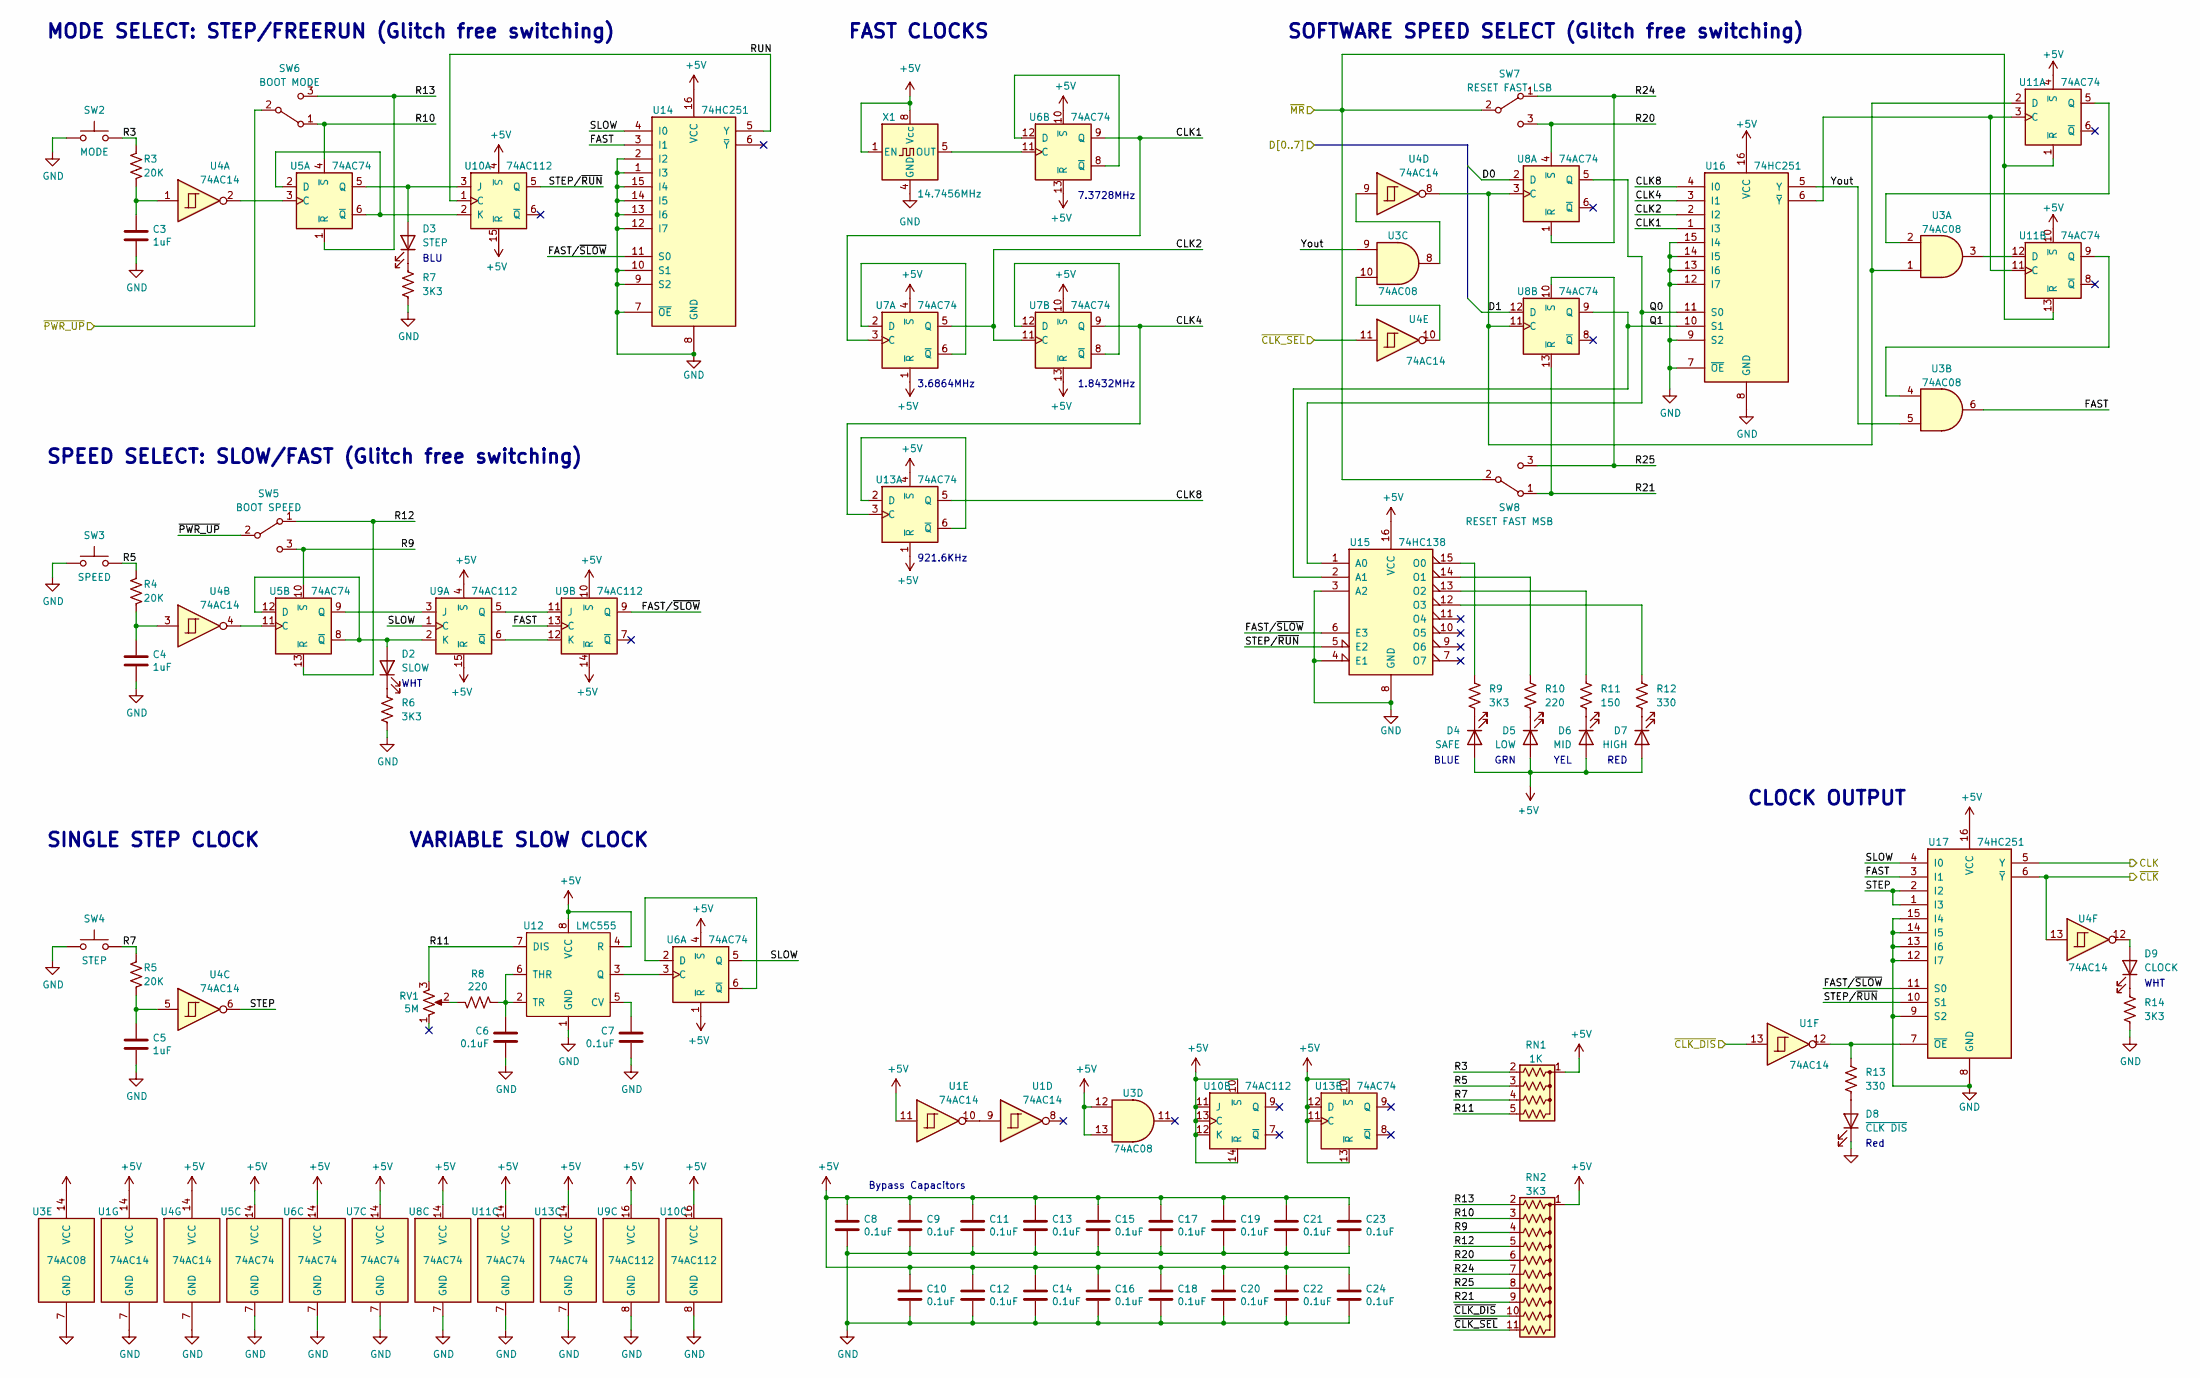
[picture p17: schematic Clock.kicad_sch, Manual and software selectable clock]

Parts:
C3, C4, C5: 1uF; C_Disc_D3.0mm_W1.6mm_P2.50mm
C6, C7, C8, C9, C10, C11, C12, C13, C14, C15, C16, C17, C18, C19, C20, C21, C22, C23, C24: 0.1uF; C_Disc_D3.0mm_W1.6mm_P2.50mm
D2: SLOW; LED_D3.0mm_Horizontal_O1.27mm_Z2.0mm_Clear
D3: STEP; LED_D3.0mm_Horizontal_O1.27mm_Z2.0mm_Clear
D4: SAFE; LED_D3.0mm_Horizontal_O1.27mm_Z2.0mm_Clear
D5: LOW; LED_D3.0mm_Horizontal_O1.27mm_Z2.0mm_Clear
D6: MID; LED_D3.0mm_Horizontal_O1.27mm_Z2.0mm_Clear
D7: HIGH; LED_D3.0mm_Horizontal_O1.27mm_Z2.0mm_Clear
D8: ~{CLK DIS}; LED_D3.0mm_Horizontal_O1.27mm_Z2.0mm_Clear
D9: CLOCK; LED_D3.0mm_Horizontal_O1.27mm_Z2.0mm_Clear
R3, R4, R5: 20K; R_Axial_DIN0207_L6.3mm_D2.5mm_P10.16mm_Horizontal
R6, R7, R9, R14: 3K3; R_Axial_DIN0207_L6.3mm_D2.5mm_P10.16mm_Horizontal
R8, R10: 220; R_Axial_DIN0207_L6.3mm_D2.5mm_P10.16mm_Horizontal
R11: 150; R_Axial_DIN0207_L6.3mm_D2.5mm_P10.16mm_Horizontal
R12, R13: 330; R_Axial_DIN0207_L6.3mm_D2.5mm_P10.16mm_Horizontal
RN1: 1K; R_Array_SIP5
RN2: 3K3; R_Array_SIP11
RV1: 5M; Potentiometer_Bourns_3296Z_Horizontal
SW2: MODE; SW_Tactile_SPST_Angled_PTS645Vx58-2LFS
SW3: SPEED; SW_Tactile_SPST_Angled_PTS645Vx58-2LFS
SW4: STEP; SW_Tactile_SPST_Angled_PTS645Vx58-2LFS
SW5: BOOT SPEED; Microswitch_4.7mm_spacing
SW6: BOOT MODE; Microswitch_4.7mm_spacing
SW7: RESET FAST LSB; Microswitch_4.7mm_spacing
SW8: RESET FAST MSB; Microswitch_4.7mm_spacing
U1, U4: 74AC14; DIP-14_W7.62mm_Socket
U3: 74AC08; DIP-14_W7.62mm_Socket
U5, U6, U7, U8, U11, U13: 74AC74; DIP-14_W7.62mm_Socket
U9, U10: 74AC112; DIP-16_W7.62mm_Socket
U12: LMC555; DIP-8_W7.62mm_Socket
U14, U16, U17: 74HC251; DIP-16_W7.62mm_Socket
U15: 74HC138; DIP-16_W7.62mm_Socket
X1: 14.7456MHz; DIP-8-4_W7.62mm_Oscillator_Socket

Connections:
/CLK: U17.5 (Y); also elsewhere on the board
/Clock/CLK1: U6.9 (Q), U7.3 (C), U16.1 (I3)
/Clock/CLK2: U7.5 (Q), U7.11 (C), U16.2 (I2)
/Clock/CLK4: U7.9 (Q), U13.3 (C), U16.3 (I1)
/Clock/CLK8: U13.5 (Q), U16.4 (I0)
/Clock/FAST: U3.6, U9.13 (C), U14.3 (I1), U17.3 (I1)
/Clock/FAST/~SLOW: U9.9 (Q), U14.11 (S0), U15.6 (E3), U17.11 (S0)
/Clock/Q0: U8.5 (Q), U15.1 (A0), U16.11 (S0)
/Clock/Q1: U8.9 (Q), U15.2 (A1), U16.10 (S1)
/Clock/R3: R3.2, RN1.2 (R1), SW2.1
/Clock/R5: R4.2, RN1.3 (R2), SW3.1
/Clock/R7: R5.2, RN1.4 (R3), SW4.1
/Clock/R9: RN2.4 (R3), SW5.3 (C), U5.10 (~S)
/Clock/R10: RN2.3 (R2), SW6.1 (A), U5.4 (~S)
/Clock/R11: RN1.5 (R4), RV1.3, U12.7 (DIS)
/Clock/R12: RN2.5 (R4), SW5.1 (A), U5.13 (~R)
/Clock/R13: RN2.2 (R1), SW6.3 (C), U5.1 (~R)
/Clock/R20: RN2.6 (R5), SW7.3 (C), U8.4 (~S)
/Clock/R21: RN2.9 (R8), SW8.1 (A), U8.13 (~R)
/Clock/R24: RN2.7 (R6), SW7.1 (A), U8.1 (~R)
/Clock/R25: RN2.8 (R7), SW8.3 (C), U8.10 (~S)
/Clock/RUN: U10.1 (C), U14.5 (Y)
/Clock/SLOW: U6.5 (Q), U9.1 (C), U14.4 (I0), U17.4 (I0)
/Clock/STEP: U4.6, U17.1 (I3), U17.2 (I2)
/Clock/STEP/~RUN: U10.5 (Q), U15.5 (E2), U17.10 (S1)
/Clock/Yout: U3.5, U3.9, U16.5 (Y)
/D0: U8.2 (D); also elsewhere on the board
/D1: U8.12 (D); also elsewhere on the board
/~CLK_DIS: RN2.10 (R9), U1.13; also elsewhere on the board
/~CLK_SEL: RN2.11 (R10), U4.11; also elsewhere on the board
/~CLK: U4.13, U17.6 (~Y); also elsewhere on the board
/~MR: SW7.2 (B), SW8.2 (B), U11.1 (~R), U11.13 (~R); also elsewhere on the board
/~PWR_UP: SW5.2 (B), SW6.2 (B); also elsewhere on the board
unnamed: C3.1, R3.1, U4.1
unnamed: C4.1, R4.1, U4.3
unnamed: C5.1, R5.1, U4.5
unnamed: C6.1, R8.2, U12.2 (TR), U12.6 (THR)
unnamed: C7.1, U12.5 (CV)
unnamed: D2.1 (K), R6.1
unnamed: D2.2 (A), U5.8 (~Q), U5.12 (D), U9.2 (K)
unnamed: D3.1 (K), R7.1
unnamed: D3.2 (A), U5.5 (Q), U10.3 (J)
unnamed: D4.1 (K), R9.2
unnamed: D5.1 (K), R10.2
unnamed: D6.1 (K), R11.2
unnamed: D7.1 (K), R12.2
unnamed: D8.2 (A), R13.2
unnamed: D9.1 (K), R14.1
unnamed: D9.2 (A), U4.12
unnamed: R8.1, RV1.2
unnamed: R9.1, U15.15 (O0)
unnamed: R10.1, U15.14 (O1)
unnamed: R11.1, U15.13 (O2)
unnamed: R12.1, U15.12 (O3)
unnamed: R13.1, U1.12, U17.7 (~OE)
unnamed: U1.9, U1.10
unnamed: U3.8, U4.9
unnamed: U3.10, U4.10
unnamed: U4.2, U5.3 (C)
unnamed: U4.4, U5.11 (C)
unnamed: U5.9 (Q), U9.3 (J)
unnamed: U6.2 (D), U6.6 (~Q)
unnamed: U6.11 (C), X1.5 (OUT)
unnamed: U6.8 (~Q), U6.12 (D)
unnamed: U7.2 (D), U7.6 (~Q)
unnamed: U7.8 (~Q), U7.12 (D)
unnamed: U9.5 (Q), U9.11 (J)
unnamed: U9.6 (~Q), U9.12 (K)
unnamed: U5.2 (D), U5.6 (~Q), U10.2 (K)
unnamed: U3.1, U4.8, U8.3 (C), U8.11 (C), U11.2 (D)
unnamed: U3.2, U11.5 (Q)
unnamed: U3.4, U11.9 (Q)
unnamed: U11.3 (C), U11.11 (C), U16.6 (~Y)
unnamed: U3.3, U11.12 (D)
unnamed: U6.3 (C), U12.3 (Q)
unnamed: U13.2 (D), U13.6 (~Q)

Notes on the sheet:
3.6864MHz
VARIABLE SLOW CLOCK
SPEED SELECT: SLOW/FAST (Glitch free switching)
Bypass Capacitors
MODE SELECT: STEP/FREERUN (Glitch free switching)
RED
FAST CLOCKS
SOFTWARE SPEED SELECT (Glitch free switching)
CLOCK OUTPUT
921.6KHz
GRN
WHT
1.8432MHz
BLU
Red
7.3728MHz
YEL
BLUE
SINGLE STEP CLOCK

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
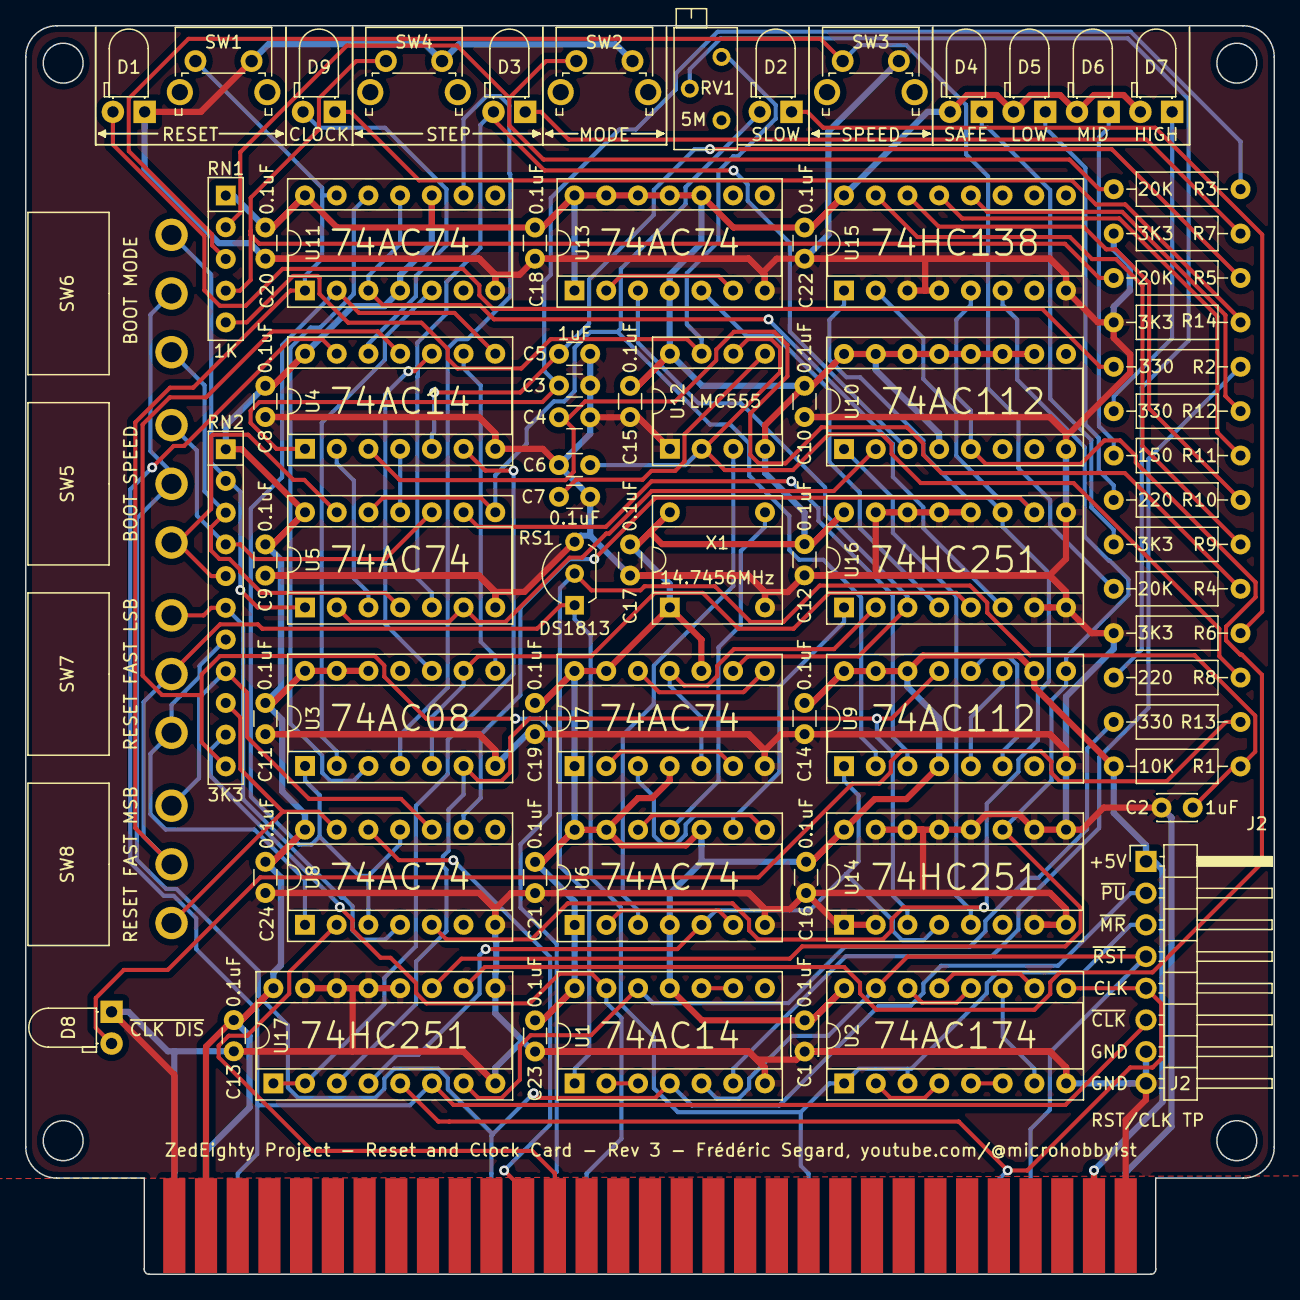
[picture p18: board Part 3 - Clock v3.kicad_pcb from above]

Board: 2 copper layers, 100.0 x 100.0 mm, 79 parts (0 on the bottom side), 88 nets.
