FredericSegard/ZedEighty-Project/DIP 68 1.778mm adaptor/DIP 68 1.778mm adaptor.kicad_pcb

## KiCad design DIP 68 1.778mm adaptor/DIP 68 1.778mm adaptor.kicad_pcb (2022-12-04)

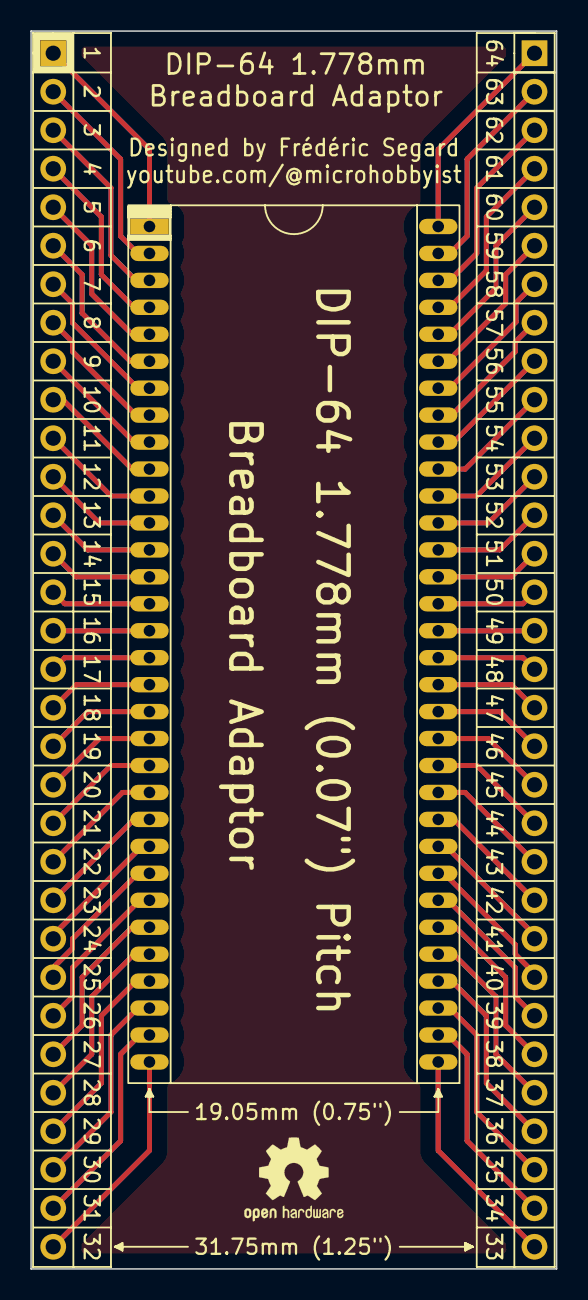
[picture p19: board DIP 68 1.778mm adaptor.kicad_pcb from above]

Board: 2 copper layers, 34.7 x 81.7 mm, 4 parts (0 on the bottom side), 64 nets.

Parts:
J1, J2: Header; PinHeader_1x32_P2.54mm_Vertical
REF1: OSHW-Logo2_7.3x6mm_SilkScreen
U1: DIP-64; DIP 64 1.778 pitch

Connections:
/1: J1.1, U1.1 (GND)
/2: J1.2, U1.2 (~DHCLK)
/3: J1.3, U1.3 (~{DLCLK)
/4: J1.4, U1.4 (~VRESET)
/5: J1.5, U1.5 (~HSYNC)
/6: J1.6, U1.6 (~CSYNC)
/7: J1.7, U1.7 (BLEO)
/8: J1.8, U1.8 (CPUCK/~VDS)
/9: J1.9, U1.9 (~RESET)
/10: J1.10, U1.10 (~YS)
/11: J1.11, U1.11 (CBDR)
/12: J1.12, U1.12 (C7)
/13: J1.13, U1.13 (C6)
/14: J1.14, U1.14 (C5)
/15: J1.15, U1.15 (C4)
/16: J1.16, U1.16 (C3)
/17: J1.17, U1.17 (C2)
/18: J1.18, U1.18 (C1)
/19: J1.19, U1.19 (C0)
/20: J1.20, U1.20 (GND_DAC)
/21: J1.21, U1.21 (VCC_DAC)
/22: J1.22, U1.22 (G)
/23: J1.23, U1.23 (R)
/24: J1.24, U1.24 (B)
/25: J1.25, U1.25 (~INT)
/26: J1.26, U1.26 (~WAIT)
/27: J1.27, U1.27 (~HRESET)
/28: J1.28, U1.28 (MODE_1)
/29: J1.29, U1.29 (MODE_0)
/30: J1.30, U1.30 (~CSW)
/31: J1.31, U1.31 (~CSR)
/32: J1.32, U1.32 (D7)
/33: J2.32, U1.33 (VBB)
/34: J2.31, U1.34 (D6)
/35: J2.30, U1.35 (D5)
/36: J2.29, U1.36 (D4)
/37: J2.28, U1.37 (D3)
/38: J2.27, U1.38 (D2)
/39: J2.26, U1.39 (D1)
/40: J2.25, U1.40 (D0)
/41: J2.24, U1.41 (RD0)
/42: J2.23, U1.42 (RD1)
/43: J2.22, U1.43 (RD2)
/44: J2.21, U1.44 (RD3)
/45: J2.20, U1.45 (RD4)
/46: J2.19, U1.46 (RD5)
/47: J2.18, U1.47 (RD6)
/48: J2.17, U1.48 (RD7)
/49: J2.16, U1.49 (AD0)
/50: J2.15, U1.50 (AD1)
/51: J2.14, U1.51 (AD2)
/52: J2.13, U1.52 (AD3)
/53: J2.12, U1.53 (AD4)
/54: J2.11, U1.54 (AD5)
/55: J2.10, U1.55 (AD6)
/56: J2.9, U1.56 (AD7)
/57: J2.8, U1.57 (R/~W)
/58: J2.7, U1.58 (VCC)
/59: J2.6, U1.59 (~CASX)
/60: J2.5, U1.60 (~CAS1)
/61: J2.4, U1.61 (~CAS0)
/62: J2.3, U1.62 (~RAS)
/63: J2.2, U1.63 (XTAL1)
/64: J2.1, U1.64 (XTAL2)
