FredericSegard/ZedEighty-Project/Part 5 - Backplane v2/Part 5 - Backplane v2.kicad_pcb

## KiCad design Part 5 - Backplane v2/Part 5 - Backplane v2.kicad_pcb (2022-11-30, an earlier design)

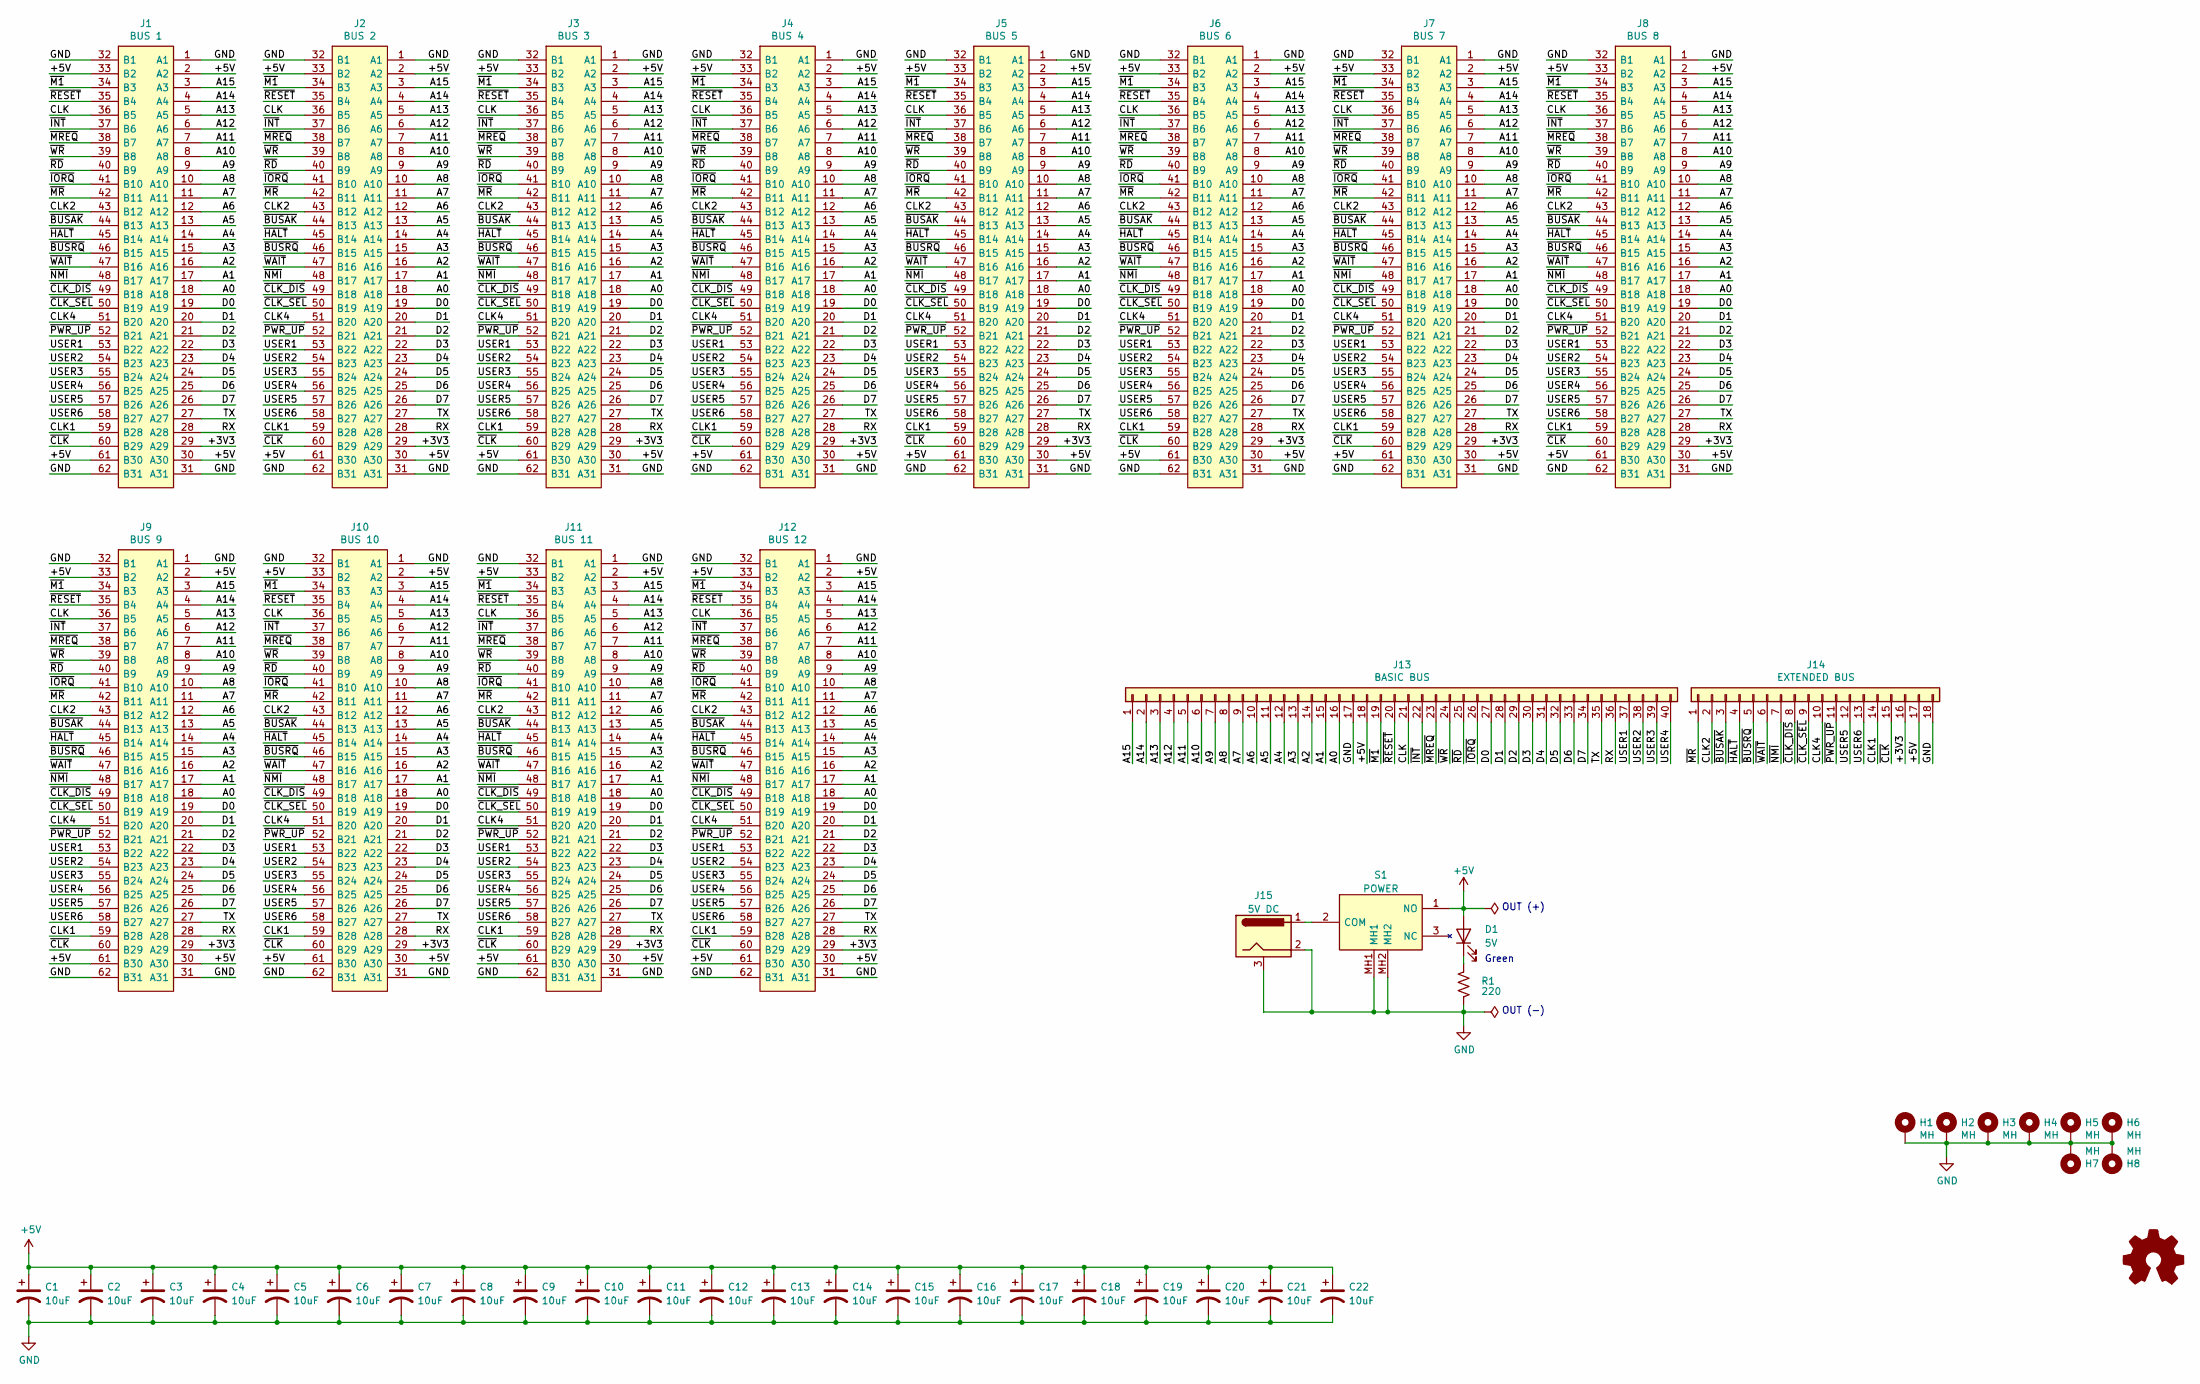
[picture p22: schematic Part 5 - Backplane v2.kicad_sch, 12-slot ISA-style backblane with breadboard connectivity]

Parts:
C1, C2, C3, C4, C5, C6, C7, C8, C9, C10, C11, C12, C13, C14, C15, C16, C17, C18, C19, C20, C21, C22: 10uF; CP_Radial_D6.3mm_P2.50mm
D1: 5V; LED_D3.0mm
H1, H2, H3, H4, H5, H6, H7, H8: MH; MountingHole_3.2mm_M3_Pad_Via
J1: BUS 1; ISA_Connector; Mouser Part Number 571-6-5530843-5
J2: BUS 2; ISA_Connector; Mouser Part Number 571-6-5530843-5
J3: BUS 3; ISA_Connector; Mouser Part Number 571-6-5530843-5
J4: BUS 4; ISA_Connector; Mouser Part Number 571-6-5530843-5
J5: BUS 5; ISA_Connector; Mouser Part Number 571-6-5530843-5
J6: BUS 6; ISA_Connector; Mouser Part Number 571-6-5530843-5
J7: BUS 7; ISA_Connector; Mouser Part Number 571-6-5530843-5
J8: BUS 8; ISA_Connector; Mouser Part Number 571-6-5530843-5
J9: BUS 9; ISA_Connector; Mouser Part Number 571-6-5530843-5
J10: BUS 10; ISA_Connector; Mouser Part Number 571-6-5530843-5
J11: BUS 11; ISA_Connector; Mouser Part Number 571-6-5530843-5
J12: BUS 12; ISA_Connector; Mouser Part Number 571-6-5530843-5
J13: BASIC BUS; PinHeader_1x40_P2.54mm_Vertical
J14: EXTENDED BUS; PinHeader_1x18_P2.54mm_Vertical
J15: 5V DC; BarrelJack_Horizontal
R1: 220; R_Axial_DIN0207_L6.3mm_D2.5mm_P10.16mm_Horizontal
S1: POWER; SPDT_NKK_SWITCH_M2012S2A2W30; Manufacturer_Part_Number M2012S2A2W30; Mouser Part Number 633-M2012S2A2W30

Connections:
+5V: C1.1, C2.1, C3.1, C4.1, C5.1, C6.1, C7.1, C8.1, C9.1, C10.1, C11.1, C12.1, C13.1, C14.1, C15.1, C16.1, C17.1, C18.1, C19.1, C20.1, C21.1, C22.1, D1.2 (A), J1.2 (A2), J1.30 (A30), J1.33 (B2), J1.61 (B30), J2.2 (A2), J2.30 (A30), J2.33 (B2), J2.61 (B30), J3.2 (A2), J3.30 (A30), J3.33 (B2), J3.61 (B30), J4.2 (A2), J4.30 (A30), J4.33 (B2), J4.61 (B30), J5.2 (A2), J5.30 (A30), J5.33 (B2), J5.61 (B30), J6.2 (A2), J6.30 (A30), J6.33 (B2), J6.61 (B30), J7.2 (A2), J7.30 (A30), J7.33 (B2), J7.61 (B30), J8.2 (A2), J8.30 (A30), J8.33 (B2), J8.61 (B30), J9.2 (A2), J9.30 (A30), J9.33 (B2), J9.61 (B30), J10.2 (A2), J10.30 (A30), J10.33 (B2), J10.61 (B30), J11.2 (A2), J11.30 (A30), J11.33 (B2), J11.61 (B30), J12.2 (A2), J12.30 (A30), J12.33 (B2), J12.61 (B30), J13.18, J14.17, S1.1 (NO)
/+3V3: J1.29 (A29), J2.29 (A29), J3.29 (A29), J4.29 (A29), J5.29 (A29), J6.29 (A29), J7.29 (A29), J8.29 (A29), J9.29 (A29), J10.29 (A29), J11.29 (A29), J12.29 (A29), J14.16
/A0: J1.18 (A18), J2.18 (A18), J3.18 (A18), J4.18 (A18), J5.18 (A18), J6.18 (A18), J7.18 (A18), J8.18 (A18), J9.18 (A18), J10.18 (A18), J11.18 (A18), J12.18 (A18), J13.16
/A1: J1.17 (A17), J2.17 (A17), J3.17 (A17), J4.17 (A17), J5.17 (A17), J6.17 (A17), J7.17 (A17), J8.17 (A17), J9.17 (A17), J10.17 (A17), J11.17 (A17), J12.17 (A17), J13.15
/A2: J1.16 (A16), J2.16 (A16), J3.16 (A16), J4.16 (A16), J5.16 (A16), J6.16 (A16), J7.16 (A16), J8.16 (A16), J9.16 (A16), J10.16 (A16), J11.16 (A16), J12.16 (A16), J13.14
/A3: J1.15 (A15), J2.15 (A15), J3.15 (A15), J4.15 (A15), J5.15 (A15), J6.15 (A15), J7.15 (A15), J8.15 (A15), J9.15 (A15), J10.15 (A15), J11.15 (A15), J12.15 (A15), J13.13
/A4: J1.14 (A14), J2.14 (A14), J3.14 (A14), J4.14 (A14), J5.14 (A14), J6.14 (A14), J7.14 (A14), J8.14 (A14), J9.14 (A14), J10.14 (A14), J11.14 (A14), J12.14 (A14), J13.12
/A5: J1.13 (A13), J2.13 (A13), J3.13 (A13), J4.13 (A13), J5.13 (A13), J6.13 (A13), J7.13 (A13), J8.13 (A13), J9.13 (A13), J10.13 (A13), J11.13 (A13), J12.13 (A13), J13.11
/A6: J1.12 (A12), J2.12 (A12), J3.12 (A12), J4.12 (A12), J5.12 (A12), J6.12 (A12), J7.12 (A12), J8.12 (A12), J9.12 (A12), J10.12 (A12), J11.12 (A12), J12.12 (A12), J13.10
/A7: J1.11 (A11), J2.11 (A11), J3.11 (A11), J4.11 (A11), J5.11 (A11), J6.11 (A11), J7.11 (A11), J8.11 (A11), J9.11 (A11), J10.11 (A11), J11.11 (A11), J12.11 (A11), J13.9
/A8: J1.10 (A10), J2.10 (A10), J3.10 (A10), J4.10 (A10), J5.10 (A10), J6.10 (A10), J7.10 (A10), J8.10 (A10), J9.10 (A10), J10.10 (A10), J11.10 (A10), J12.10 (A10), J13.8
/A9: J1.9 (A9), J2.9 (A9), J3.9 (A9), J4.9 (A9), J5.9 (A9), J6.9 (A9), J7.9 (A9), J8.9 (A9), J9.9 (A9), J10.9 (A9), J11.9 (A9), J12.9 (A9), J13.7
/A10: J1.8 (A8), J2.8 (A8), J3.8 (A8), J4.8 (A8), J5.8 (A8), J6.8 (A8), J7.8 (A8), J8.8 (A8), J9.8 (A8), J10.8 (A8), J11.8 (A8), J12.8 (A8), J13.6
/A11: J1.7 (A7), J2.7 (A7), J3.7 (A7), J4.7 (A7), J5.7 (A7), J6.7 (A7), J7.7 (A7), J8.7 (A7), J9.7 (A7), J10.7 (A7), J11.7 (A7), J12.7 (A7), J13.5
/A12: J1.6 (A6), J2.6 (A6), J3.6 (A6), J4.6 (A6), J5.6 (A6), J6.6 (A6), J7.6 (A6), J8.6 (A6), J9.6 (A6), J10.6 (A6), J11.6 (A6), J12.6 (A6), J13.4
/A13: J1.5 (A5), J2.5 (A5), J3.5 (A5), J4.5 (A5), J5.5 (A5), J6.5 (A5), J7.5 (A5), J8.5 (A5), J9.5 (A5), J10.5 (A5), J11.5 (A5), J12.5 (A5), J13.3
/A14: J1.4 (A4), J2.4 (A4), J3.4 (A4), J4.4 (A4), J5.4 (A4), J6.4 (A4), J7.4 (A4), J8.4 (A4), J9.4 (A4), J10.4 (A4), J11.4 (A4), J12.4 (A4), J13.2
/A15: J1.3 (A3), J2.3 (A3), J3.3 (A3), J4.3 (A3), J5.3 (A3), J6.3 (A3), J7.3 (A3), J8.3 (A3), J9.3 (A3), J10.3 (A3), J11.3 (A3), J12.3 (A3), J13.1
/CLK: J1.36 (B5), J2.36 (B5), J3.36 (B5), J4.36 (B5), J5.36 (B5), J6.36 (B5), J7.36 (B5), J8.36 (B5), J9.36 (B5), J10.36 (B5), J11.36 (B5), J12.36 (B5), J13.21
/CLK1: J1.59 (B28), J2.59 (B28), J3.59 (B28), J4.59 (B28), J5.59 (B28), J6.59 (B28), J7.59 (B28), J8.59 (B28), J9.59 (B28), J10.59 (B28), J11.59 (B28), J12.59 (B28), J14.14
/CLK2: J1.43 (B12), J2.43 (B12), J3.43 (B12), J4.43 (B12), J5.43 (B12), J6.43 (B12), J7.43 (B12), J8.43 (B12), J9.43 (B12), J10.43 (B12), J11.43 (B12), J12.43 (B12), J14.2
/CLK4: J1.51 (B20), J2.51 (B20), J3.51 (B20), J4.51 (B20), J5.51 (B20), J6.51 (B20), J7.51 (B20), J8.51 (B20), J9.51 (B20), J10.51 (B20), J11.51 (B20), J12.51 (B20), J14.10
/D0: J1.19 (A19), J2.19 (A19), J3.19 (A19), J4.19 (A19), J5.19 (A19), J6.19 (A19), J7.19 (A19), J8.19 (A19), J9.19 (A19), J10.19 (A19), J11.19 (A19), J12.19 (A19), J13.27
/D1: J1.20 (A20), J2.20 (A20), J3.20 (A20), J4.20 (A20), J5.20 (A20), J6.20 (A20), J7.20 (A20), J8.20 (A20), J9.20 (A20), J10.20 (A20), J11.20 (A20), J12.20 (A20), J13.28
/D2: J1.21 (A21), J2.21 (A21), J3.21 (A21), J4.21 (A21), J5.21 (A21), J6.21 (A21), J7.21 (A21), J8.21 (A21), J9.21 (A21), J10.21 (A21), J11.21 (A21), J12.21 (A21), J13.29
/D3: J1.22 (A22), J2.22 (A22), J3.22 (A22), J4.22 (A22), J5.22 (A22), J6.22 (A22), J7.22 (A22), J8.22 (A22), J9.22 (A22), J10.22 (A22), J11.22 (A22), J12.22 (A22), J13.30
/D4: J1.23 (A23), J2.23 (A23), J3.23 (A23), J4.23 (A23), J5.23 (A23), J6.23 (A23), J7.23 (A23), J8.23 (A23), J9.23 (A23), J10.23 (A23), J11.23 (A23), J12.23 (A23), J13.31
/D5: J1.24 (A24), J2.24 (A24), J3.24 (A24), J4.24 (A24), J5.24 (A24), J6.24 (A24), J7.24 (A24), J8.24 (A24), J9.24 (A24), J10.24 (A24), J11.24 (A24), J12.24 (A24), J13.32
/D6: J1.25 (A25), J2.25 (A25), J3.25 (A25), J4.25 (A25), J5.25 (A25), J6.25 (A25), J7.25 (A25), J8.25 (A25), J9.25 (A25), J10.25 (A25), J11.25 (A25), J12.25 (A25), J13.33
/D7: J1.26 (A26), J2.26 (A26), J3.26 (A26), J4.26 (A26), J5.26 (A26), J6.26 (A26), J7.26 (A26), J8.26 (A26), J9.26 (A26), J10.26 (A26), J11.26 (A26), J12.26 (A26), J13.34
/RX: J1.28 (A28), J2.28 (A28), J3.28 (A28), J4.28 (A28), J5.28 (A28), J6.28 (A28), J7.28 (A28), J8.28 (A28), J9.28 (A28), J10.28 (A28), J11.28 (A28), J12.28 (A28), J13.36
/TX: J1.27 (A27), J2.27 (A27), J3.27 (A27), J4.27 (A27), J5.27 (A27), J6.27 (A27), J7.27 (A27), J8.27 (A27), J9.27 (A27), J10.27 (A27), J11.27 (A27), J12.27 (A27), J13.35
/USER1: J1.53 (B22), J2.53 (B22), J3.53 (B22), J4.53 (B22), J5.53 (B22), J6.53 (B22), J7.53 (B22), J8.53 (B22), J9.53 (B22), J10.53 (B22), J11.53 (B22), J12.53 (B22), J13.37
/USER2: J1.54 (B23), J2.54 (B23), J3.54 (B23), J4.54 (B23), J5.54 (B23), J6.54 (B23), J7.54 (B23), J8.54 (B23), J9.54 (B23), J10.54 (B23), J11.54 (B23), J12.54 (B23), J13.38
/USER3: J1.55 (B24), J2.55 (B24), J3.55 (B24), J4.55 (B24), J5.55 (B24), J6.55 (B24), J7.55 (B24), J8.55 (B24), J9.55 (B24), J10.55 (B24), J11.55 (B24), J12.55 (B24), J13.39
/USER4: J1.56 (B25), J2.56 (B25), J3.56 (B25), J4.56 (B25), J5.56 (B25), J6.56 (B25), J7.56 (B25), J8.56 (B25), J9.56 (B25), J10.56 (B25), J11.56 (B25), J12.56 (B25), J13.40
/USER5: J1.57 (B26), J2.57 (B26), J3.57 (B26), J4.57 (B26), J5.57 (B26), J6.57 (B26), J7.57 (B26), J8.57 (B26), J9.57 (B26), J10.57 (B26), J11.57 (B26), J12.57 (B26), J14.12
/USER6: J1.58 (B27), J2.58 (B27), J3.58 (B27), J4.58 (B27), J5.58 (B27), J6.58 (B27), J7.58 (B27), J8.58 (B27), J9.58 (B27), J10.58 (B27), J11.58 (B27), J12.58 (B27), J14.13
/~BUSAK: J1.44 (B13), J2.44 (B13), J3.44 (B13), J4.44 (B13), J5.44 (B13), J6.44 (B13), J7.44 (B13), J8.44 (B13), J9.44 (B13), J10.44 (B13), J11.44 (B13), J12.44 (B13), J14.3
/~BUSRQ: J1.46 (B15), J2.46 (B15), J3.46 (B15), J4.46 (B15), J5.46 (B15), J6.46 (B15), J7.46 (B15), J8.46 (B15), J9.46 (B15), J10.46 (B15), J11.46 (B15), J12.46 (B15), J14.5
/~CLK_DIS: J1.49 (B18), J2.49 (B18), J3.49 (B18), J4.49 (B18), J5.49 (B18), J6.49 (B18), J7.49 (B18), J8.49 (B18), J9.49 (B18), J10.49 (B18), J11.49 (B18), J12.49 (B18), J14.8
/~CLK_SEL: J1.50 (B19), J2.50 (B19), J3.50 (B19), J4.50 (B19), J5.50 (B19), J6.50 (B19), J7.50 (B19), J8.50 (B19), J9.50 (B19), J10.50 (B19), J11.50 (B19), J12.50 (B19), J14.9
/~CLK: J1.60 (B29), J2.60 (B29), J3.60 (B29), J4.60 (B29), J5.60 (B29), J6.60 (B29), J7.60 (B29), J8.60 (B29), J9.60 (B29), J10.60 (B29), J11.60 (B29), J12.60 (B29), J14.15
/~HALT: J1.45 (B14), J2.45 (B14), J3.45 (B14), J4.45 (B14), J5.45 (B14), J6.45 (B14), J7.45 (B14), J8.45 (B14), J9.45 (B14), J10.45 (B14), J11.45 (B14), J12.45 (B14), J14.4
/~INT: J1.37 (B6), J2.37 (B6), J3.37 (B6), J4.37 (B6), J5.37 (B6), J6.37 (B6), J7.37 (B6), J8.37 (B6), J9.37 (B6), J10.37 (B6), J11.37 (B6), J12.37 (B6), J13.22
/~IORQ: J1.41 (B10), J2.41 (B10), J3.41 (B10), J4.41 (B10), J5.41 (B10), J6.41 (B10), J7.41 (B10), J8.41 (B10), J9.41 (B10), J10.41 (B10), J11.41 (B10), J12.41 (B10), J13.26
/~M1: J1.34 (B3), J2.34 (B3), J3.34 (B3), J4.34 (B3), J5.34 (B3), J6.34 (B3), J7.34 (B3), J8.34 (B3), J9.34 (B3), J10.34 (B3), J11.34 (B3), J12.34 (B3), J13.19
/~MREQ: J1.38 (B7), J2.38 (B7), J3.38 (B7), J4.38 (B7), J5.38 (B7), J6.38 (B7), J7.38 (B7), J8.38 (B7), J9.38 (B7), J10.38 (B7), J11.38 (B7), J12.38 (B7), J13.23
/~MR: J1.42 (B11), J2.42 (B11), J3.42 (B11), J4.42 (B11), J5.42 (B11), J6.42 (B11), J7.42 (B11), J8.42 (B11), J9.42 (B11), J10.42 (B11), J11.42 (B11), J12.42 (B11), J14.1
/~NMI: J1.48 (B17), J2.48 (B17), J3.48 (B17), J4.48 (B17), J5.48 (B17), J6.48 (B17), J7.48 (B17), J8.48 (B17), J9.48 (B17), J10.48 (B17), J11.48 (B17), J12.48 (B17), J14.7
/~PWR_UP: J1.52 (B21), J2.52 (B21), J3.52 (B21), J4.52 (B21), J5.52 (B21), J6.52 (B21), J7.52 (B21), J8.52 (B21), J9.52 (B21), J10.52 (B21), J11.52 (B21), J12.52 (B21), J14.11
/~RD: J1.40 (B9), J2.40 (B9), J3.40 (B9), J4.40 (B9), J5.40 (B9), J6.40 (B9), J7.40 (B9), J8.40 (B9), J9.40 (B9), J10.40 (B9), J11.40 (B9), J12.40 (B9), J13.25
/~RESET: J1.35 (B4), J2.35 (B4), J3.35 (B4), J4.35 (B4), J5.35 (B4), J6.35 (B4), J7.35 (B4), J8.35 (B4), J9.35 (B4), J10.35 (B4), J11.35 (B4), J12.35 (B4), J13.20
/~WAIT: J1.47 (B16), J2.47 (B16), J3.47 (B16), J4.47 (B16), J5.47 (B16), J6.47 (B16), J7.47 (B16), J8.47 (B16), J9.47 (B16), J10.47 (B16), J11.47 (B16), J12.47 (B16), J14.6
/~WR: J1.39 (B8), J2.39 (B8), J3.39 (B8), J4.39 (B8), J5.39 (B8), J6.39 (B8), J7.39 (B8), J8.39 (B8), J9.39 (B8), J10.39 (B8), J11.39 (B8), J12.39 (B8), J13.24
GND: C1.2, C2.2, C3.2, C4.2, C5.2, C6.2, C7.2, C8.2, C9.2, C10.2, C11.2, C12.2, C13.2, C14.2, C15.2, C16.2, C17.2, C18.2, C19.2, C20.2, C21.2, C22.2, H1.1, H2.1, H3.1, H4.1, H5.1, H6.1, H7.1, H8.1, J1.1 (A1), J1.31 (A31), J1.32 (B1), J1.62 (B31), J2.1 (A1), J2.31 (A31), J2.32 (B1), J2.62 (B31), J3.1 (A1), J3.31 (A31), J3.32 (B1), J3.62 (B31), J4.1 (A1), J4.31 (A31), J4.32 (B1), J4.62 (B31), J5.1 (A1), J5.31 (A31), J5.32 (B1), J5.62 (B31), J6.1 (A1), J6.31 (A31), J6.32 (B1), J6.62 (B31), J7.1 (A1), J7.31 (A31), J7.32 (B1), J7.62 (B31), J8.1 (A1), J8.31 (A31), J8.32 (B1), J8.62 (B31), J9.1 (A1), J9.31 (A31), J9.32 (B1), J9.62 (B31), J10.1 (A1), J10.31 (A31), J10.32 (B1), J10.62 (B31), J11.1 (A1), J11.31 (A31), J11.32 (B1), J11.62 (B31), J12.1 (A1), J12.31 (A31), J12.32 (B1), J12.62 (B31), J13.17, J14.18, J15.2, J15.3, R1.1, S1.MH1, S1.MH2
unnamed: D1.1 (K), R1.2
unnamed: J15.1, S1.2 (COM)

Notes on the sheet:
OUT (+)
Green
OUT (-)

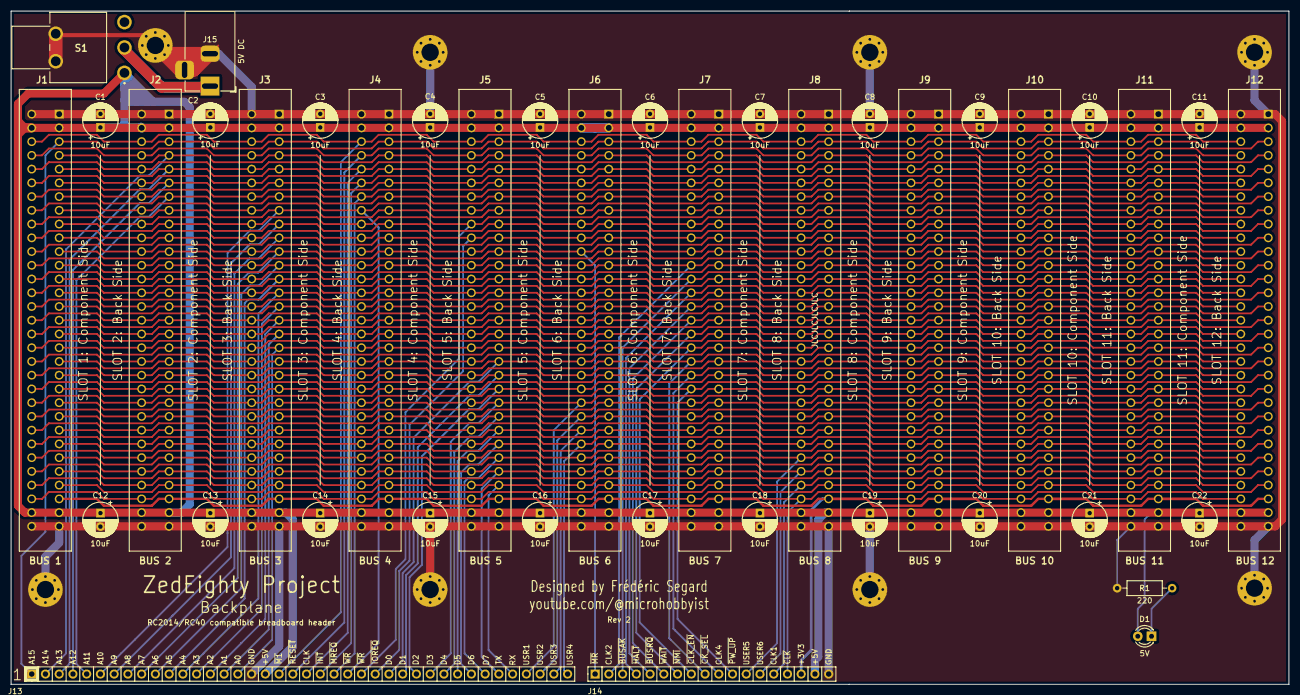
[picture p23: board Part 5 - Backplane v2.kicad_pcb from above]

Board: 2 copper layers, 236.2 x 124.5 mm, 48 parts (0 on the bottom side), 58 nets.
