FredericSegard/ZedEighty-Project/Part 7 - Keyboard/Part 7 - Keyboard.kicad_pcb

## KiCad design Part 7 - Keyboard/Part 7 - Keyboard.kicad_pcb (2022-11-30)

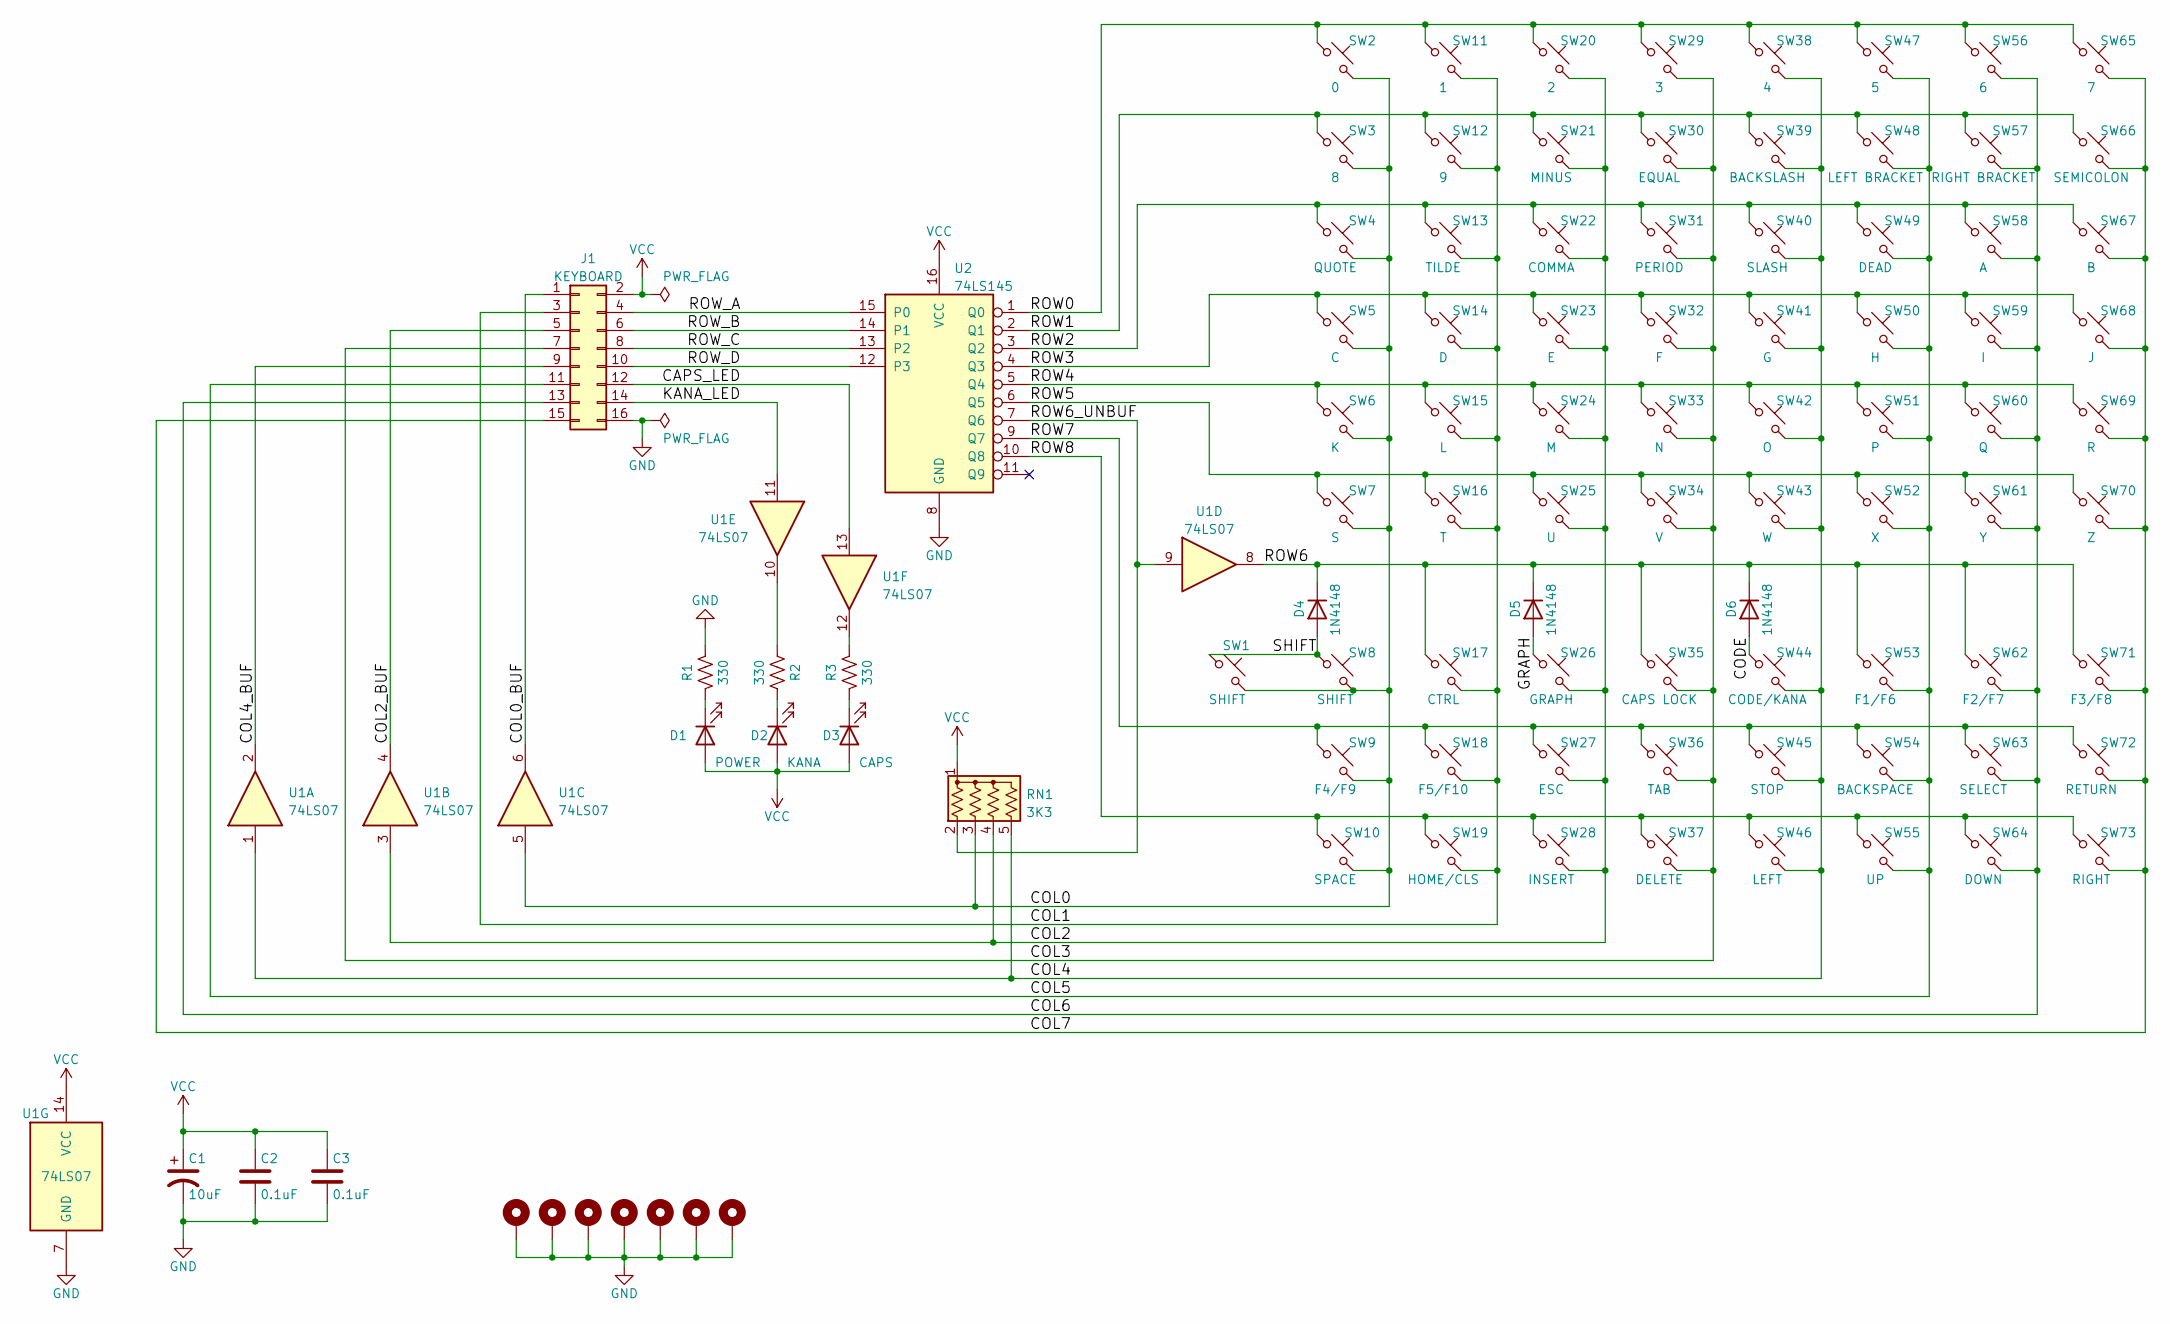
[picture p24: schematic Part 7 - Keyboard.kicad_sch, MSX Compatible Keyboard]

Parts:
C1: 10uF; CP_Radial_D5.0mm_P2.50mm
C2, C3: 0.1uF; C_Disc_D3.0mm_W2.0mm_P2.50mm
D1: POWER; LED_D3.0mm
D2: KANA; LED_D3.0mm
D3: CAPS; LED_D3.0mm
D4, D5, D6: 1N4148; D_DO-35_SOD27_P7.62mm_Horizontal
H1: MH; MountingHole_3.2mm_M3_Pad_Via
H2, H3, H4, H5, H6, H7: MountingHole_Pad; MountingHole_3.2mm_M3_Pad_Via
J1: KEYBOARD; PinSocket_2x08_P2.54mm_Vertical
R1, R2, R3: 330; R_Axial_DIN0204_L3.6mm_D1.6mm_P7.62mm_Horizontal
RN1: 3K3; R_Array_SIP5
SW1: SHIFT; SW_Cherry_MX_2.75u_PCB
SW2: 0; SW_Cherry_MX_1.00u_PCB
SW3: 8; SW_Cherry_MX_1.00u_PCB
SW4: QUOTE; SW_Cherry_MX_1.00u_PCB
SW5: C; SW_Cherry_MX_1.00u_PCB
SW6: K; SW_Cherry_MX_1.00u_PCB
SW7: S; SW_Cherry_MX_1.00u_PCB
SW8: SHIFT; SW_Cherry_MX_2.25u_PCB
SW9: F4/F9; SW_Cherry_MX_1.00u_PCB
SW10: SPACE; SW_Cherry_MX_6.25u_PCB
SW11: 1; SW_Cherry_MX_1.00u_PCB
SW12: 9; SW_Cherry_MX_1.00u_PCB
SW13: TILDE; SW_Cherry_MX_1.00u_PCB
SW14: D; SW_Cherry_MX_1.00u_PCB
SW15: L; SW_Cherry_MX_1.00u_PCB
SW16: T; SW_Cherry_MX_1.00u_PCB
SW17: CTRL; SW_Cherry_MX_1.25u_PCB
SW18: F5/F10; SW_Cherry_MX_1.00u_PCB
SW19: HOME/CLS; SW_Cherry_MX_1.00u_PCB
SW20: 2; SW_Cherry_MX_1.00u_PCB
SW21: MINUS; SW_Cherry_MX_1.00u_PCB
SW22: COMMA; SW_Cherry_MX_1.00u_PCB
SW23: E; SW_Cherry_MX_1.00u_PCB
SW24: M; SW_Cherry_MX_1.00u_PCB
SW25: U; SW_Cherry_MX_1.00u_PCB
SW26: GRAPH; SW_Cherry_MX_1.25u_PCB
SW27: ESC; SW_Cherry_MX_1.00u_PCB
SW28: INSERT; SW_Cherry_MX_1.00u_PCB
SW29: 3; SW_Cherry_MX_1.00u_PCB
SW30: EQUAL; SW_Cherry_MX_1.00u_PCB
SW31: PERIOD; SW_Cherry_MX_1.00u_PCB
SW32: F; SW_Cherry_MX_1.00u_PCB
SW33: N; SW_Cherry_MX_1.00u_PCB
SW34: V; SW_Cherry_MX_1.00u_PCB
SW35: CAPS LOCK; SW_Cherry_MX_1.75u_PCB
SW36: TAB; SW_Cherry_MX_1.50u_PCB
SW37: DELETE; SW_Cherry_MX_1.00u_PCB
SW38: 4; SW_Cherry_MX_1.00u_PCB
SW39: BACKSLASH; SW_Cherry_MX_1.50u_PCB
SW40: SLASH; SW_Cherry_MX_1.00u_PCB
SW41: G; SW_Cherry_MX_1.00u_PCB
SW42: O; SW_Cherry_MX_1.00u_PCB
SW43: W; SW_Cherry_MX_1.00u_PCB
SW44: CODE/KANA; SW_Cherry_MX_1.25u_PCB
SW45: STOP; SW_Cherry_MX_1.00u_PCB
SW46: LEFT; SW_Cherry_MX_1.00u_PCB
SW47: 5; SW_Cherry_MX_1.00u_PCB
SW48: LEFT BRACKET; SW_Cherry_MX_1.00u_PCB
SW49: DEAD; SW_Cherry_MX_1.25u_PCB
SW50: H; SW_Cherry_MX_1.00u_PCB
SW51: P; SW_Cherry_MX_1.00u_PCB
SW52: X; SW_Cherry_MX_1.00u_PCB
SW53: F1/F6; SW_Cherry_MX_1.00u_PCB
SW54: BACKSPACE; SW_Cherry_MX_2.00u_PCB
SW55: UP; SW_Cherry_MX_1.00u_PCB
SW56: 6; SW_Cherry_MX_1.00u_PCB
SW57: RIGHT BRACKET; SW_Cherry_MX_1.00u_PCB
SW58: A; SW_Cherry_MX_1.00u_PCB
SW59: I; SW_Cherry_MX_1.00u_PCB
SW60: Q; SW_Cherry_MX_1.00u_PCB
SW61: Y; SW_Cherry_MX_1.00u_PCB
SW62: F2/F7; SW_Cherry_MX_1.00u_PCB
SW63: SELECT; SW_Cherry_MX_1.25u_PCB
SW64: DOWN; SW_Cherry_MX_1.00u_PCB
SW65: 7; SW_Cherry_MX_1.00u_PCB
SW66: SEMICOLON; SW_Cherry_MX_1.00u_PCB
SW67: B; SW_Cherry_MX_1.00u_PCB
SW68: J; SW_Cherry_MX_1.00u_PCB
SW69: R; SW_Cherry_MX_1.00u_PCB
SW70: Z; SW_Cherry_MX_1.00u_PCB
SW71: F3/F8; SW_Cherry_MX_1.00u_PCB
SW72: RETURN; SW_Cherry_MX_2.25u_PCB
SW73: RIGHT; SW_Cherry_MX_1.00u_PCB
U1: 74LS07; DIP-14_W7.62mm_Socket
U2: 74LS145; DIP-16_W7.62mm_Socket

Connections:
/CAPS_LED: J1.12, U1.13
/CODE: D6.2 (A), SW44.1
/COL0: RN1.3 (R2), SW1.2, SW2.2, SW3.2, SW4.2, SW5.2, SW6.2, SW7.2, SW8.2, SW9.2, SW10.2, U1.5
/COL0_BUF: J1.1, U1.6
/COL1: J1.3, SW11.2, SW12.2, SW13.2, SW14.2, SW15.2, SW16.2, SW17.2, SW18.2, SW19.2
/COL2: RN1.4 (R3), SW20.2, SW21.2, SW22.2, SW23.2, SW24.2, SW25.2, SW26.2, SW27.2, SW28.2, U1.3
/COL2_BUF: J1.5, U1.4
/COL3: J1.7, SW29.2, SW30.2, SW31.2, SW32.2, SW33.2, SW34.2, SW35.2, SW36.2, SW37.2
/COL4: RN1.5 (R4), SW38.2, SW39.2, SW40.2, SW41.2, SW42.2, SW43.2, SW44.2, SW45.2, SW46.2, U1.1
/COL4_BUF: J1.9, U1.2
/COL5: J1.11, SW47.2, SW48.2, SW49.2, SW50.2, SW51.2, SW52.2, SW53.2, SW54.2, SW55.2
/COL6: J1.13, SW56.2, SW57.2, SW58.2, SW59.2, SW60.2, SW61.2, SW62.2, SW63.2, SW64.2
/COL7: J1.15, SW65.2, SW66.2, SW67.2, SW68.2, SW69.2, SW70.2, SW71.2, SW72.2, SW73.2
/GRAPH: D5.2 (A), SW26.1
/KANA_LED: J1.14, U1.11
/ROW0: SW2.1, SW11.1, SW20.1, SW29.1, SW38.1, SW47.1, SW56.1, SW65.1, U2.1 (Q0)
/ROW1: SW3.1, SW12.1, SW21.1, SW30.1, SW39.1, SW48.1, SW57.1, SW66.1, U2.2 (Q1)
/ROW2: SW4.1, SW13.1, SW22.1, SW31.1, SW40.1, SW49.1, SW58.1, SW67.1, U2.3 (Q2)
/ROW3: SW5.1, SW14.1, SW23.1, SW32.1, SW41.1, SW50.1, SW59.1, SW68.1, U2.4 (Q3)
/ROW4: SW6.1, SW15.1, SW24.1, SW33.1, SW42.1, SW51.1, SW60.1, SW69.1, U2.5 (Q4)
/ROW5: SW7.1, SW16.1, SW25.1, SW34.1, SW43.1, SW52.1, SW61.1, SW70.1, U2.6 (Q5)
/ROW6: D4.1 (K), D5.1 (K), D6.1 (K), SW17.1, SW35.1, SW53.1, SW62.1, SW71.1, U1.8
/ROW6_UNBUF: RN1.2 (R1), U1.9, U2.7 (Q6)
/ROW7: SW9.1, SW18.1, SW27.1, SW36.1, SW45.1, SW54.1, SW63.1, SW72.1, U2.9 (Q7)
/ROW8: SW10.1, SW19.1, SW28.1, SW37.1, SW46.1, SW55.1, SW64.1, SW73.1, U2.10 (Q8)
/ROW_A: J1.4, U2.15 (P0)
/ROW_B: J1.6, U2.14 (P1)
/ROW_C: J1.8, U2.13 (P2)
/ROW_D: J1.10, U2.12 (P3)
/SHIFT: D4.2 (A), SW1.1, SW8.1
GND: C1.2, C2.2, C3.2, H1.1, H2.1, H3.1, H4.1, H5.1, H6.1, H7.1, J1.16, R1.1, U1.7 (GND), U2.8 (GND)
unnamed: D1.1 (K), R1.2
unnamed: D2.1 (K), R2.2
unnamed: D3.1 (K), R3.2
unnamed: R2.1, U1.10
unnamed: R3.1, U1.12
VCC: C1.1, C2.1, C3.1, D1.2 (A), D2.2 (A), D3.2 (A), J1.2, RN1.1 (common), U1.14 (VCC), U2.16 (VCC)

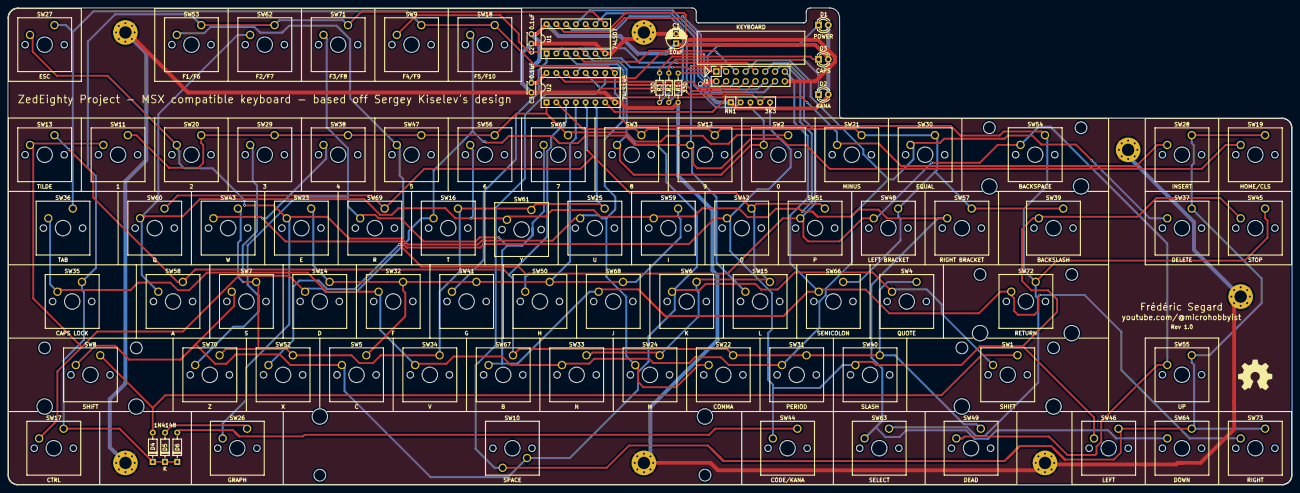
[picture p25: board Part 7 - Keyboard.kicad_pcb from above]

Board: 2 copper layers, 333.4 x 123.8 mm, 98 parts (1 on the bottom side), 37 nets.

Other parts of the board:
REF3, REF4: OSHW-Symbol_8.9x8mm_SilkScreen
