FredericSegard/ZedEighty-Project/Part 3 - Mapping things out/Part 3 - Mapping things out.kicad_pcb

## KiCad design Part 3 - Mapping things out/Part 3 - Mapping things out.kicad_pcb (2022-10-28)

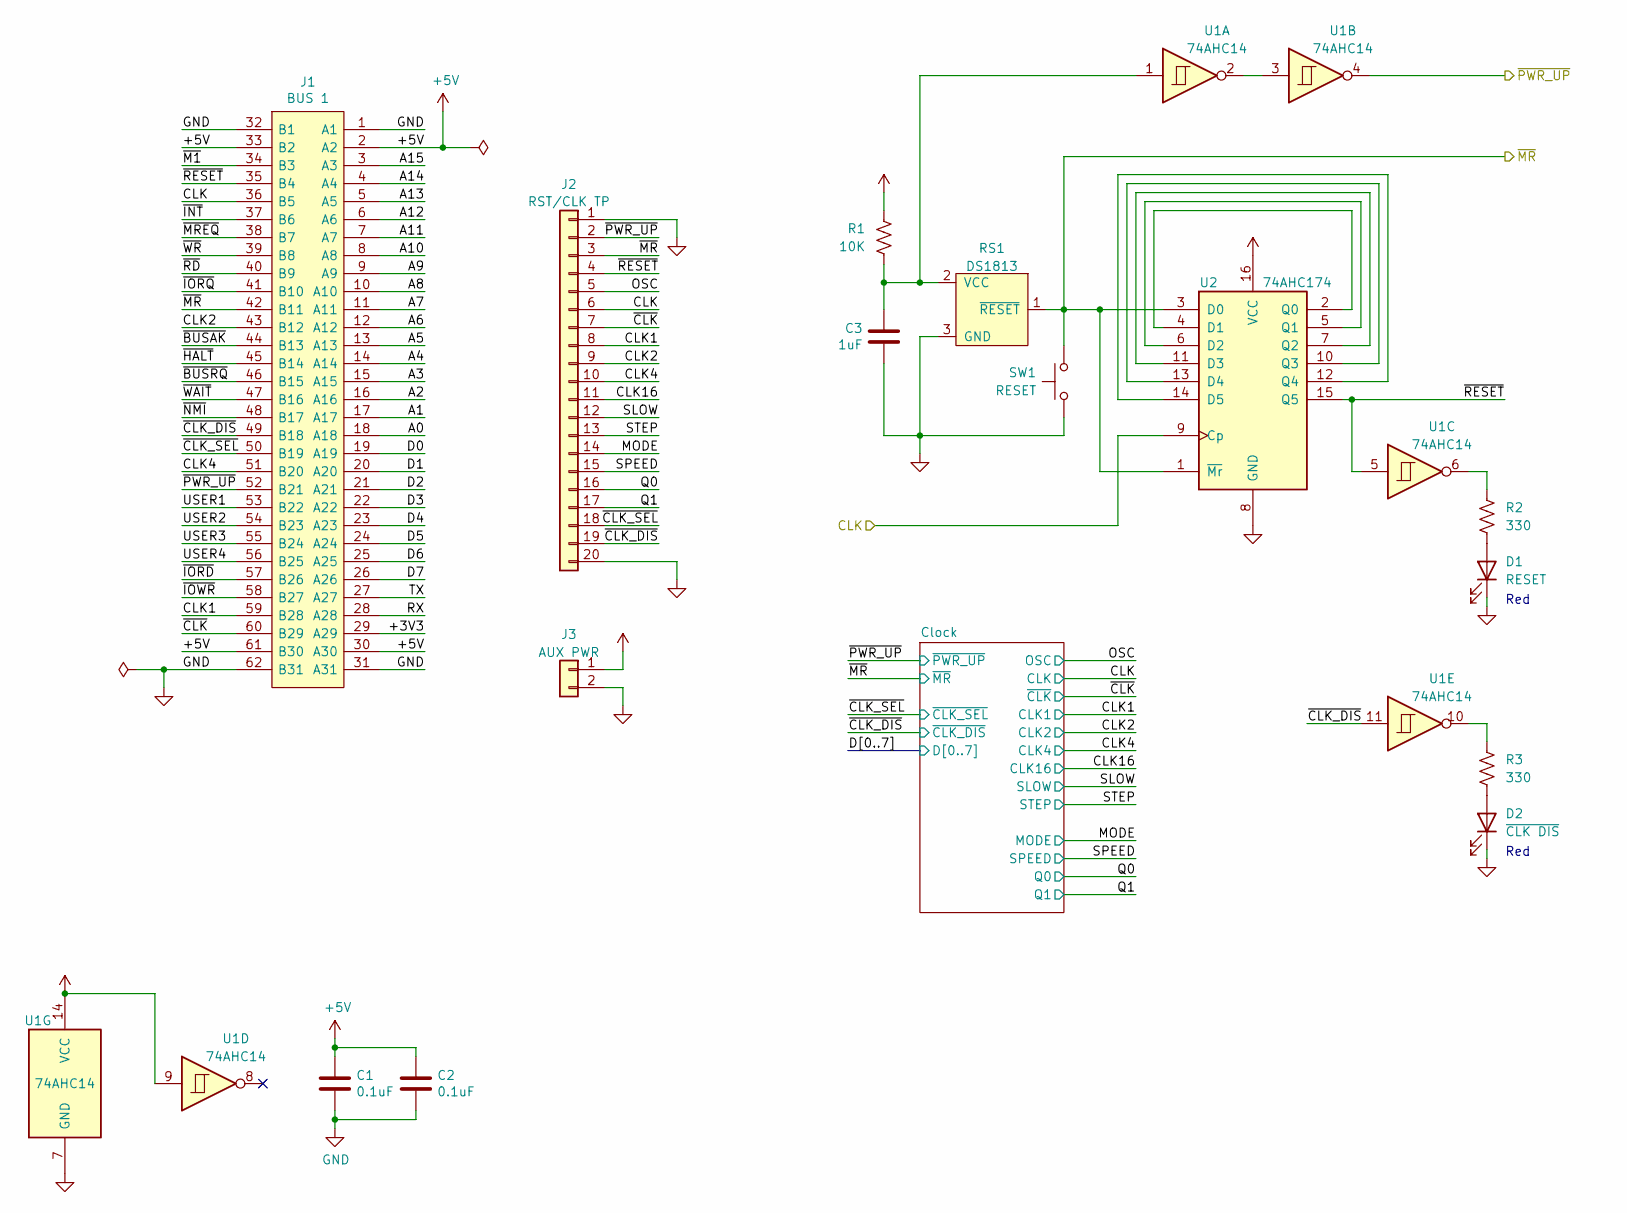
[picture p26: schematic Part 3 - Mapping things out.kicad_sch, Micro Hobbyist's ZedEighty Project]

Parts:
C1, C2: 0.1uF; C_Disc_D3.0mm_W2.0mm_P2.50mm
C3: 1uF; C_Disc_D3.0mm_W2.0mm_P2.50mm
D1: RESET; LED_D3.0mm_Horizontal_O1.27mm_Z2.0mm_Clear
D2: ~{CLK DIS}; LED_D3.0mm_Horizontal_O1.27mm_Z2.0mm_Clear
J1: BUS 1; BUS_XT; Mouser Part Number 571-6-5530843-5
J2: RST/CLK TP; PinSocket_1x20_P2.54mm_Horizontal
J3: AUX PWR; PinSocket_1x02_P2.54mm_Horizontal
R1: 10K; R_Axial_DIN0207_L6.3mm_D2.5mm_P10.16mm_Horizontal
R2, R3: 330; R_Axial_DIN0207_L6.3mm_D2.5mm_P10.16mm_Horizontal
RS1: DS1813; TO-92L_Inline_Wide
SW1: RESET; SW_Tactile_SPST_Angled_PTS645Vx58-2LFS
U1: 74AHC14; DIP-14_W7.62mm_Socket
U2: 74AHC174; DIP-16_W7.62mm_Socket

Connections:
/+3V3: J1.29 (A29)
/A0: J1.18 (A18)
/A1: J1.17 (A17)
/A2: J1.16 (A16)
/A3: J1.15 (A15)
/A4: J1.14 (A14)
/A5: J1.13 (A13)
/A6: J1.12 (A12)
/A7: J1.11 (A11)
/A8: J1.10 (A10)
/A9: J1.9 (A9)
/A10: J1.8 (A8)
/A11: J1.7 (A7)
/A12: J1.6 (A6)
/A13: J1.5 (A5)
/A14: J1.4 (A4)
/A15: J1.3 (A3)
/CLK: J1.36 (B5), J2.6, U2.9 (Cp); also elsewhere on the board
/CLK1: J1.59 (B28), J2.8; also elsewhere on the board
/CLK2: J1.43 (B12), J2.9; also elsewhere on the board
/CLK4: J1.51 (B20), J2.10; also elsewhere on the board
/CLK16: J2.11; also elsewhere on the board
/D0: J1.19 (A19); also elsewhere on the board
/D1: J1.20 (A20); also elsewhere on the board
/D2: J1.21 (A21)
/D3: J1.22 (A22)
/D4: J1.23 (A23)
/D5: J1.24 (A24)
/D6: J1.25 (A25)
/D7: J1.26 (A26)
/MODE: J2.14; also elsewhere on the board
/OSC: J2.5; also elsewhere on the board
/Q0: J2.16; also elsewhere on the board
/Q1: J2.17; also elsewhere on the board
/RX: J1.28 (A28)
/SLOW: J2.12; also elsewhere on the board
/SPEED: J2.15; also elsewhere on the board
/STEP: J2.13; also elsewhere on the board
/TX: J1.27 (A27)
/USER1: J1.53 (B22)
/USER2: J1.54 (B23)
/USER3: J1.55 (B24)
/USER4: J1.56 (B25)
/USER5: J1.57 (B26)
/USER6: J1.58 (B27)
/~BUSAK: J1.44 (B13)
/~BUSRQ: J1.46 (B15)
/~CLK_DIS: J1.49 (B18), J2.19, U1.11; also elsewhere on the board
/~CLK_SEL: J1.50 (B19), J2.18; also elsewhere on the board
/~CLK: J1.60 (B29), J2.7; also elsewhere on the board
/~HALT: J1.45 (B14)
/~INT: J1.37 (B6)
/~IORQ: J1.41 (B10)
/~M1: J1.34 (B3)
/~MREQ: J1.38 (B7)
/~MR: J1.42 (B11), J2.3, RS1.1 (~RESET), SW1.1, U2.1 (~Mr), U2.3 (D0); also elsewhere on the board
/~NMI: J1.48 (B17)
/~PWR_UP: J1.52 (B21), J2.2, U1.4; also elsewhere on the board
/~RD: J1.40 (B9)
/~RESET: J1.35 (B4), J2.4, U1.5, U2.15 (Q5)
/~WAIT: J1.47 (B16)
/~WR: J1.39 (B8)
unnamed: C3.1, R1.1, RS1.2 (VCC), U1.1
unnamed: D1.2 (A), R2.2
unnamed: D2.2 (A), R3.2
unnamed: R2.1, U1.6
unnamed: R3.1, U1.10
unnamed: U1.2, U1.3
unnamed: U2.2 (Q0), U2.4 (D1)
unnamed: U2.5 (Q1), U2.6 (D2)
unnamed: U2.10 (Q3), U2.13 (D4)
unnamed: U2.7 (Q2), U2.11 (D3)
unnamed: U2.12 (Q4), U2.14 (D5)

Notes on the sheet:
Red
