FredericSegard/ZedEighty-Project/Part 3 - Mapping things out/Part 3 - Mapping things out.kicad_pcb

## KiCad design Part 3 - Mapping things out/Part 3 - Mapping things out.kicad_pcb (continued)

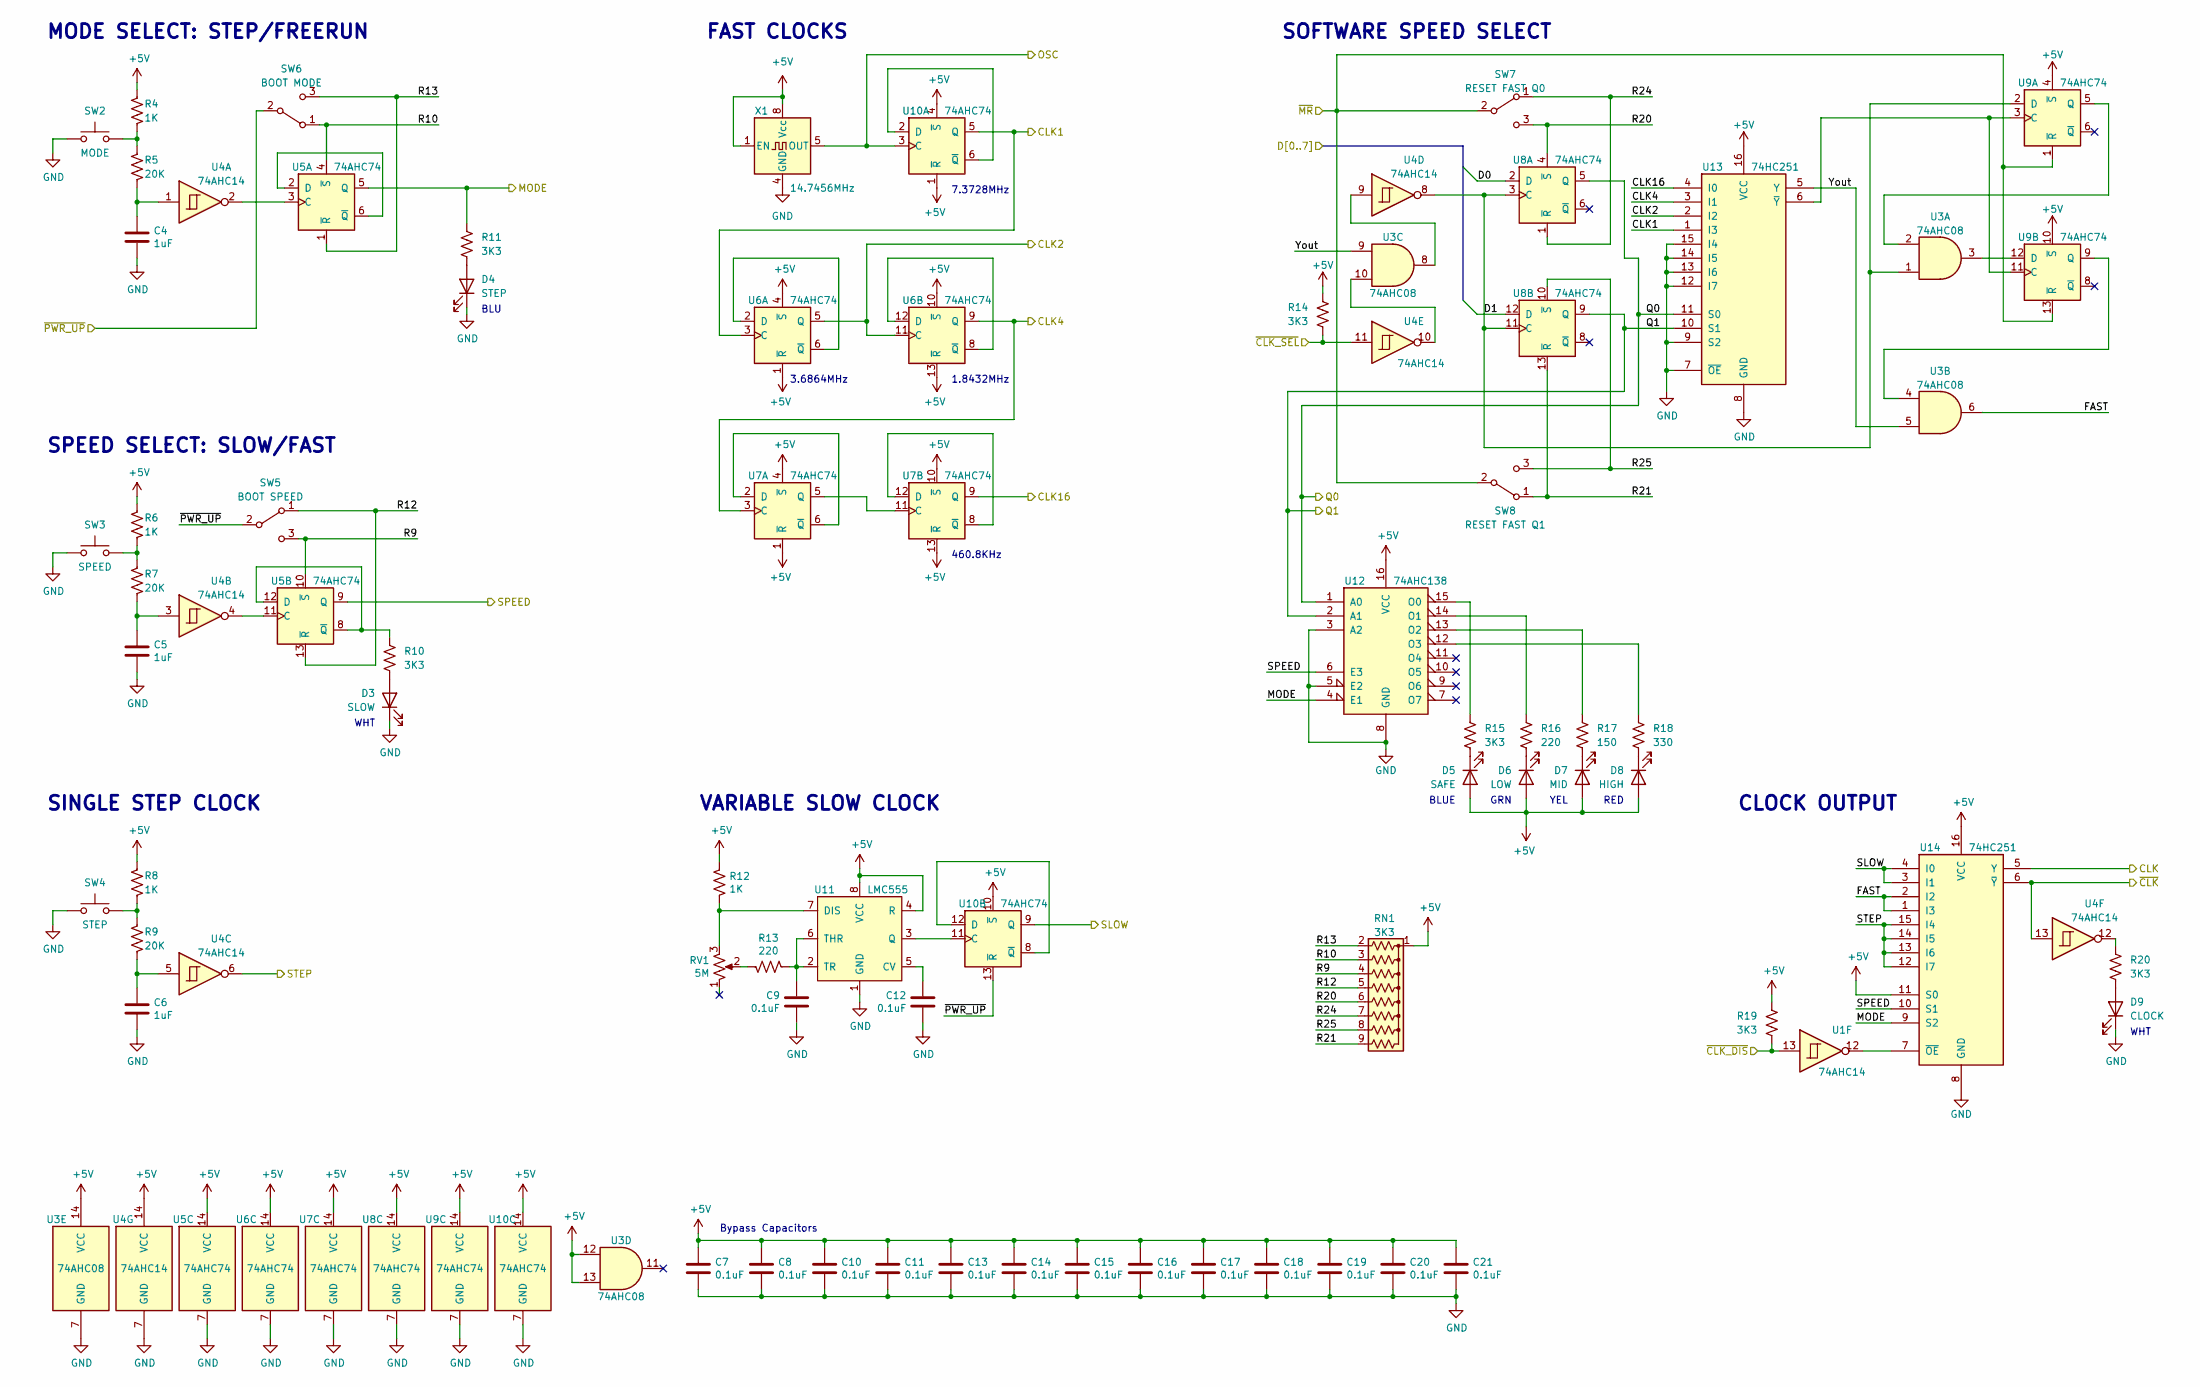
[picture p27: schematic Clock.kicad_sch, Manual and software selectable clock]

Parts:
C4, C5, C6: 1uF; C_Disc_D3.0mm_W1.6mm_P2.50mm
C7, C8, C9, C10, C11, C12, C13, C14, C15, C16, C17, C18, C19, C20, C21: 0.1uF; C_Disc_D3.0mm_W1.6mm_P2.50mm
D3: SLOW; LED_D3.0mm_Horizontal_O1.27mm_Z2.0mm_Clear
D4: STEP; LED_D3.0mm_Horizontal_O1.27mm_Z2.0mm_Clear
D5: SAFE; LED_D3.0mm_Horizontal_O1.27mm_Z2.0mm_Clear
D6: LOW; LED_D3.0mm_Horizontal_O1.27mm_Z2.0mm_Clear
D7: MID; LED_D3.0mm_Horizontal_O1.27mm_Z2.0mm_Clear
D8: HIGH; LED_D3.0mm_Horizontal_O1.27mm_Z2.0mm_Clear
D9: CLOCK; LED_D3.0mm_Horizontal_O1.27mm_Z2.0mm_Clear
R4, R6, R8, R12: 1K; R_Axial_DIN0207_L6.3mm_D2.5mm_P10.16mm_Horizontal
R5, R7, R9: 20K; R_Axial_DIN0207_L6.3mm_D2.5mm_P10.16mm_Horizontal
R10, R11, R14, R15, R19, R20: 3K3; R_Axial_DIN0207_L6.3mm_D2.5mm_P10.16mm_Horizontal
R13, R16: 220; R_Axial_DIN0207_L6.3mm_D2.5mm_P10.16mm_Horizontal
R17: 150; R_Axial_DIN0207_L6.3mm_D2.5mm_P10.16mm_Horizontal
R18: 330; R_Axial_DIN0207_L6.3mm_D2.5mm_P10.16mm_Horizontal
RN1: 3K3; R_Array_SIP9
RV1: 5M; Potentiometer_Bourns_3006P_Horizontal
SW2: MODE; SW_Tactile_SPST_Angled_PTS645Vx58-2LFS
SW3: SPEED; SW_Tactile_SPST_Angled_PTS645Vx58-2LFS
SW4: STEP; SW_Tactile_SPST_Angled_PTS645Vx58-2LFS
SW5: BOOT SPEED; Microswitch_4.7mm_spacing
SW6: BOOT MODE; Microswitch_4.7mm_spacing
SW7: RESET FAST Q0; Microswitch_4.7mm_spacing
SW8: RESET FAST Q1; Microswitch_4.7mm_spacing
U1, U4: 74AHC14; DIP-14_W7.62mm_Socket
U3: 74AHC08; DIP-14_W7.62mm_Socket
U5, U6, U7, U8, U9, U10: 74AHC74; DIP-14_W7.62mm_Socket
U11: LMC555; DIP-8_W7.62mm_Socket
U12: 74AHC138; DIP-16_W7.62mm_Socket
U13, U14: 74HC251; DIP-16_W7.62mm_Socket
X1: 14.7456MHz; DIP-8-4_W7.62mm_Oscillator_Socket

Connections:
/CLK: U14.5 (Y); also elsewhere on the board
/CLK1: U6.3 (C), U10.5 (Q), U13.1 (I3); also elsewhere on the board
/CLK2: U6.5 (Q), U6.11 (C), U13.2 (I2); also elsewhere on the board
/CLK4: U6.9 (Q), U7.3 (C), U13.3 (I1); also elsewhere on the board
/CLK16: U7.9 (Q), U13.4 (I0); also elsewhere on the board
/Clock/FAST: U3.6, U14.1 (I3), U14.2 (I2)
/Clock/R9: RN1.4 (R3), SW5.3 (C), U5.10 (~S)
/Clock/R10: RN1.3 (R2), SW6.1 (A), U5.4 (~S)
/Clock/R12: RN1.5 (R4), SW5.1 (A), U5.13 (~R)
/Clock/R13: RN1.2 (R1), SW6.3 (C), U5.1 (~R)
/Clock/R20: RN1.6 (R5), SW7.3 (C), U8.4 (~S)
/Clock/R21: RN1.9 (R8), SW8.1 (A), U8.13 (~R)
/Clock/R24: RN1.7 (R6), SW7.1 (A), U8.1 (~R)
/Clock/R25: RN1.8 (R7), SW8.3 (C), U8.10 (~S)
/Clock/Yout: U3.5, U3.9, U13.5 (Y)
/D0: U8.2 (D); also elsewhere on the board
/D1: U8.12 (D); also elsewhere on the board
/MODE: R11.1, U5.5 (Q), U12.4 (E1), U14.9 (S2); also elsewhere on the board
/OSC: U10.3 (C), X1.5 (OUT); also elsewhere on the board
/Q0: U8.5 (Q), U12.1 (A0), U13.11 (S0); also elsewhere on the board
/Q1: U8.9 (Q), U12.2 (A1), U13.10 (S1); also elsewhere on the board
/SLOW: U10.9 (Q), U14.3 (I1), U14.4 (I0); also elsewhere on the board
/SPEED: U5.9 (Q), U12.6 (E3), U14.10 (S1); also elsewhere on the board
/STEP: U4.6, U14.12 (I7), U14.13 (I6), U14.14 (I5), U14.15 (I4); also elsewhere on the board
/~CLK_DIS: R19.1, U1.13; also elsewhere on the board
/~CLK_SEL: R14.1, U4.11; also elsewhere on the board
/~CLK: U4.13, U14.6 (~Y); also elsewhere on the board
/~MR: SW7.2 (B), SW8.2 (B), U9.1 (~R), U9.13 (~R); also elsewhere on the board
/~PWR_UP: SW5.2 (B), SW6.2 (B), U10.13 (~R); also elsewhere on the board
unnamed: C4.1, R5.1, U4.1
unnamed: C5.1, R7.1, U4.3
unnamed: C6.1, R9.1, U4.5
unnamed: C9.1, R13.2, U11.2 (TR), U11.6 (THR)
unnamed: C12.1, U11.5 (CV)
unnamed: D3.2 (A), R10.2
unnamed: D4.2 (A), R11.2
unnamed: D5.1 (K), R15.2
unnamed: D6.1 (K), R16.2
unnamed: D7.1 (K), R17.2
unnamed: D8.1 (K), R18.2
unnamed: D9.2 (A), R20.2
unnamed: R4.2, R5.2, SW2.1
unnamed: R6.2, R7.2, SW3.1
unnamed: R8.2, R9.2, SW4.1
unnamed: R10.1, U5.8 (~Q), U5.12 (D)
unnamed: R12.2, RV1.3, U11.7 (DIS)
unnamed: R13.1, RV1.2
unnamed: R15.1, U12.15 (O0)
unnamed: R16.1, U12.14 (O1)
unnamed: R17.1, U12.13 (O2)
unnamed: R18.1, U12.12 (O3)
unnamed: R20.1, U4.12
unnamed: U1.12, U14.7 (~OE)
unnamed: U3.1, U4.8, U8.3 (C), U8.11 (C), U9.2 (D)
unnamed: U3.2, U9.5 (Q)
unnamed: U3.3, U9.12 (D)
unnamed: U3.4, U9.9 (Q)
unnamed: U3.8, U4.9
unnamed: U3.10, U4.10
unnamed: U4.2, U5.3 (C)
unnamed: U4.4, U5.11 (C)
unnamed: U5.2 (D), U5.6 (~Q)
unnamed: U6.2 (D), U6.6 (~Q)
unnamed: U6.8 (~Q), U6.12 (D)
unnamed: U7.2 (D), U7.6 (~Q)
unnamed: U7.5 (Q), U7.11 (C)
unnamed: U7.8 (~Q), U7.12 (D)
unnamed: U10.2 (D), U10.6 (~Q)
unnamed: U10.11 (C), U11.3 (Q)
unnamed: U10.8 (~Q), U10.12 (D)
unnamed: U9.3 (C), U9.11 (C), U13.6 (~Y)

Notes on the sheet:
3.6864MHz
VARIABLE SLOW CLOCK
SPEED SELECT: SLOW/FAST
Bypass Capacitors
MODE SELECT: STEP/FREERUN
RED
FAST CLOCKS
SOFTWARE SPEED SELECT
CLOCK OUTPUT
GRN
WHT
1.8432MHz
BLU
7.3728MHz
YEL
BLUE
460.8KHz
SINGLE STEP CLOCK

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
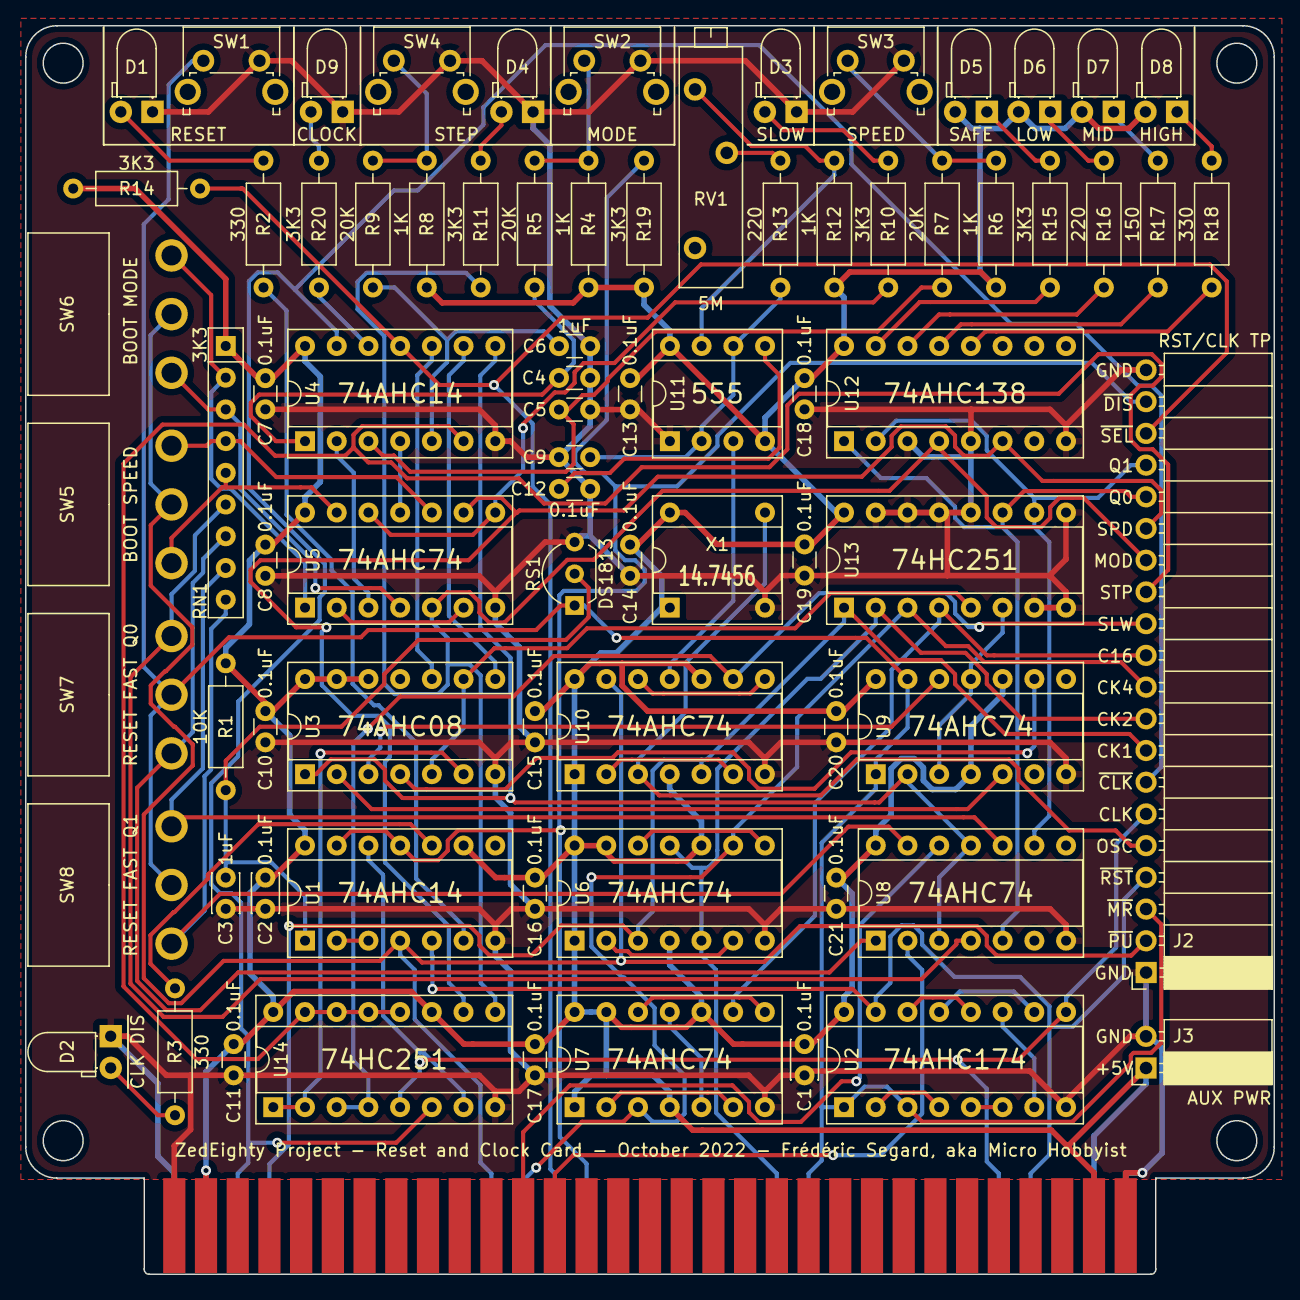
[picture p28: board Part 3 - Mapping things out.kicad_pcb from above]

Board: 2 copper layers, 100.0 x 100.0 mm, 79 parts (0 on the bottom side), 85 nets.
