FredericSegard/ZedEighty-Project/(commit log)

2022-09-30 Updating resistor values and added PDF schematic
    [Part 1 - Testing the Z80.kicad_sch]
2022-09-30 Added Part 2, and part of Part 3
    [Clock.kicad_sch, Part 2 - Latching power switch.kicad_pcb, Part 2 - Latching power switch.kicad_sch, Part 3 - Improving clock options.kicad_pcb, Part 3 - Improving clock options.kicad_sch, Power.kicad_sch, Reset.kicad_sch]
2022-09-30 Worked on Part 3's clock
    [Clock.kicad_sch, Part 3 - Improving clock options.kicad_sch, Power.kicad_sch, Reset.kicad_sch]
2022-10-03 Finished clock in part 2, added part 3
    [CPU and memory.kicad_sch, Clock.kicad_sch, Part 1 - Testing the Z80.kicad_sch, Part 2 - Improving clock options.kicad_pcb, Part 2 - Improving clock options.kicad_sch, Part 2 - Latching power switch.kicad_sch, Part 3 - Improving clock options.kicad_sch, Part 3 - Mapping things out.kicad_pcb]
2022-10-03 Updated glue logic and bank switching
    [CPU and memory.kicad_sch, Clock.kicad_sch, Part 3 - Mapping things out.kicad_sch]
2022-10-14 Backplane PCB sent out, and experimented with clock options
    [CPU and memory.kicad_sch, Clock.kicad_sch, M2012S2A2W30.step, Part 3 - Mapping things out.kicad_sch, Part 4 - CPU and memory.kicad_pcb, Part 4 - CPU and memory.kicad_sch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]
2022-10-21 Added software selectable speed control
    [Clock.kicad_sch, FastClockSwitching.circ, Part 3 - Mapping things out.kicad_pcb, Part 3 - Mapping things out.kicad_sch, Speed_RGB_LED.circ]
2022-10-28 Updated clock, and created CPU card
    [CPU and memory.kicad_sch, Clock.kicad_sch, FastClockSwitching.circ, Part 3 - 4 layers.kicad_pcb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]
2022-11-01 Changed the clock for even cleaner clock switching
    [Clock.kicad_sch, FastClockSwitching.circ, Part 3 - Clock v3.kicad_pcb, Part 3 - Clock v3.kicad_sch, Part 4 - CPU and memory.kicad_pcb, Part 4 - CPU and memory.kicad_sch, Part 5 - Backplane.kicad_pcb, Part 5 - Backplane.kicad_sch]
2022-11-01 Attempted to reduce chip count
    [Clock.kicad_sch, Part 3 - Clock v3.kicad_pcb, Part 3 - Clock v3.kicad_sch]
2022-11-07 Clock 3 and Keyboard
    [Clock.kicad_sch, Part 3 - Clock v3.dsn, Part 3 - Clock v3.kicad_pcb, Part 3 - Clock v3.kicad_sch, Part 4 - CPU and memory.kicad_sch, Part 7 - Keyboard.kicad_pcb, Part 7 - Keyboard.kicad_sch, Part 7 - Keyboard.sch]
2022-11-30 Added Keyboard, and minor fixes
    [Clock.kicad_sch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]
2022-12-04 Updated key library and keyboard
    [DIP 68 1.778mm adaptor-B_Cu.gbl, DIP 68 1.778mm adaptor-B_Mask.gbs, DIP 68 1.778mm adaptor-B_Paste.gbp, DIP 68 1.778mm adaptor-B_Silkscreen.gbo, DIP 68 1.778mm adaptor-Edge_Cuts.gm1, DIP 68 1.778mm adaptor-F_Cu.gtl, DIP 68 1.778mm adaptor-F_Mask.gts, DIP 68 1.778mm adaptor-F_Paste.gtp]
2023-01-05 Long time backup
    [Part 3 - Clock v3.kicad_sch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]
